cemis-iceland/co2_sensor_node/3D_models/SOP-8_4.4x5.0mm_P1.27mm.step

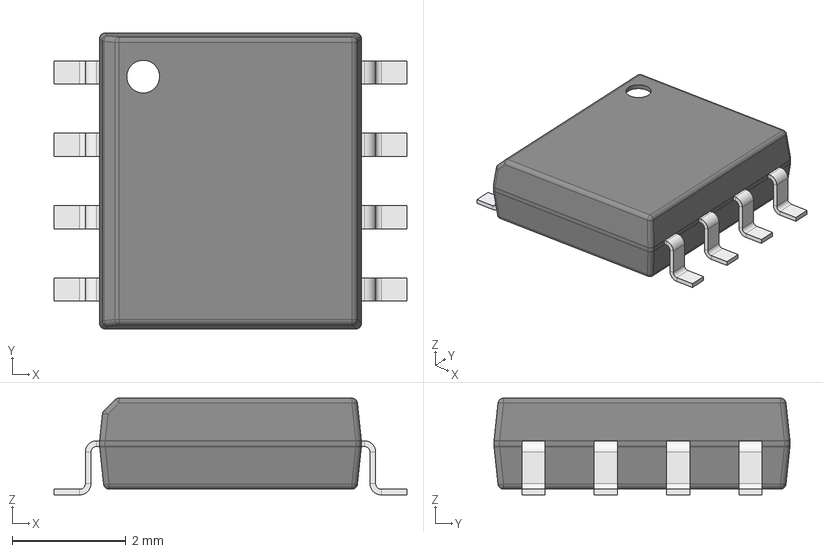
[picture p1: CAD file, 2022-05-19]
3D_models/SOP-8_4.4x5.0mm_P1.27mm.step
6.20 x 5.20 x 1.70 mm
Open_CASCADE_STEP_translator_6.8_1.1
Open_CASCADE_STEP_translator_6.8_1.2.1
Leader x 8
