cemis-iceland/co2_sensor_node/co2_sensor_node.step

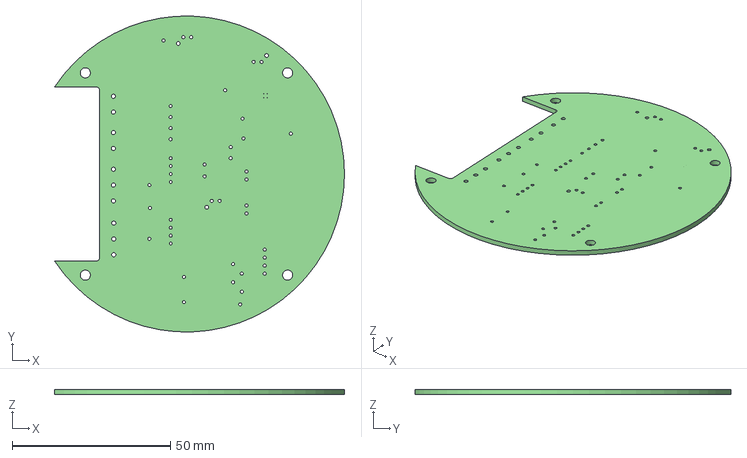
[picture p2: CAD file, 2022-07-26]
co2_sensor_node.step
91.7 x 99.9 x 1.60 mm
