cemis-iceland/co2_sensor_node/(list of files, cad)

Other CAD files:
3D_models/co2_sensor_node.step
