cemis-iceland/co2_sensor_node/(threads)

Thread 5 (2021-06-03):

I2C lines on input only pins on ESP32

manaljosid, 2021-06-03:
The I2C lines are connected to the input only pins on the ESP32. Move them to the two other free pins.

cemis-iceland, 2021-06-14:
Resolved in 2f20cff

Closed 2021-06-14.

Thread 8 (2021-06-15):

PMOS in CO2 sensor loadswitch is corrected incorrectly

cemis-iceland, 2021-06-15:
The source and drain are swapped.

manaljosid, 2021-06-21:
PMOS rotated to work correctly.

Closed 2021-06-21.

Thread 11 (2022-06-23):

Battery header reversed

manaljosid, 2022-06-23:
The battery header is reversed compared to other designs we've made, fix plz

Thread 12 (2022-06-23):

Add 220uF capacitor to the 3V3 rail and charge resistor to 220uF capacitor on the 3V3 switched rail

manaljosid, 2022-06-23:
The 220uF capacitor on the 3V3 switched rail triggers a brownout on the ESP32, fix by adding a chonk capacitor to the 3V3 rail and a charge resistor to the 3V3 switched capacitor

Thread 15 (2022-06-24):

Voltage stability for ADC

manaljosid, 2022-06-24:
The battery voltage measurements and soil moisture measurements rely on the internal ESP32 ADC. The reference for that ADC is the same 3V3 bus as is used for the rest of the board which is very noisy.

manaljosid, 2022-06-27:
Measurements show that the peak-to-peak voltage on the 3V3 rail is roughly 50 mV p-p while the RMS voltage is about 20 mV RMS.
