cemis-iceland/co2_sensor_node/PDFs/co2_sensor_node-2022-06-07.pdf

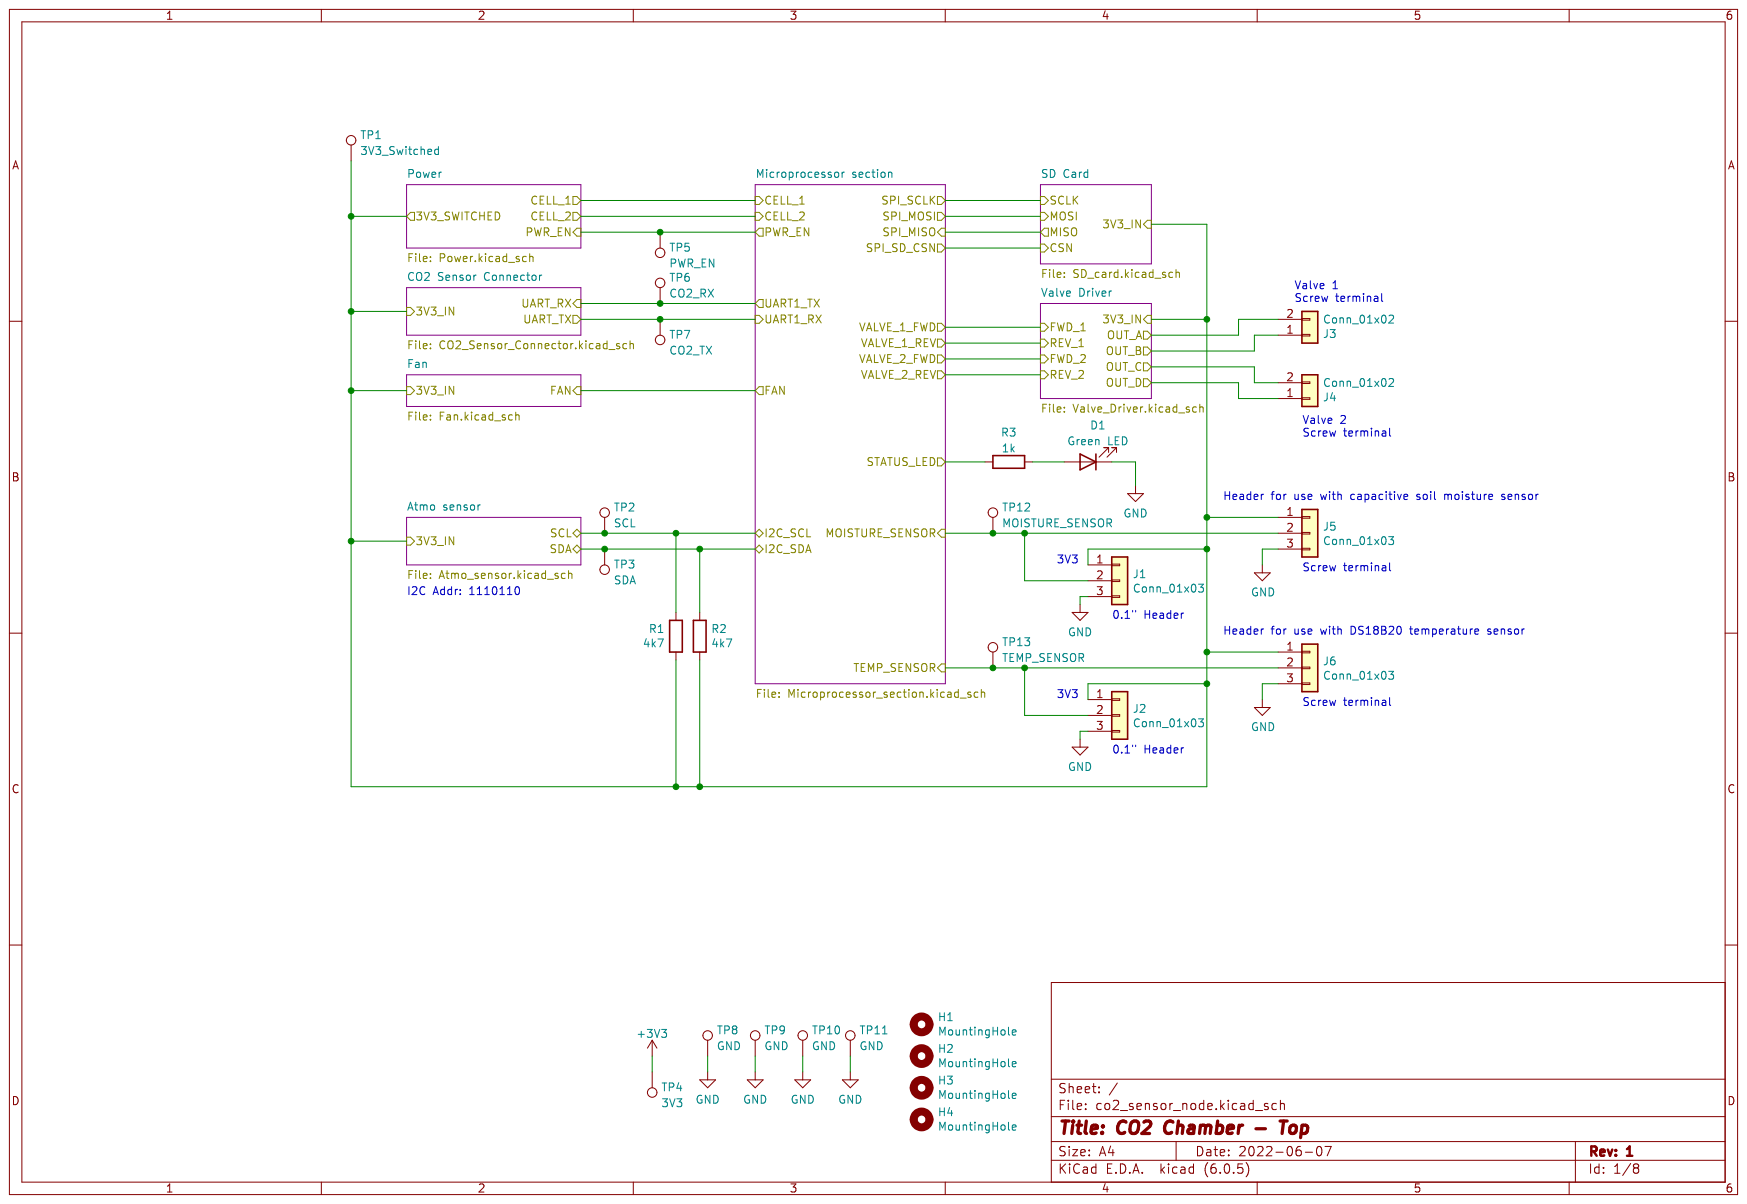
[picture p11: page 1]

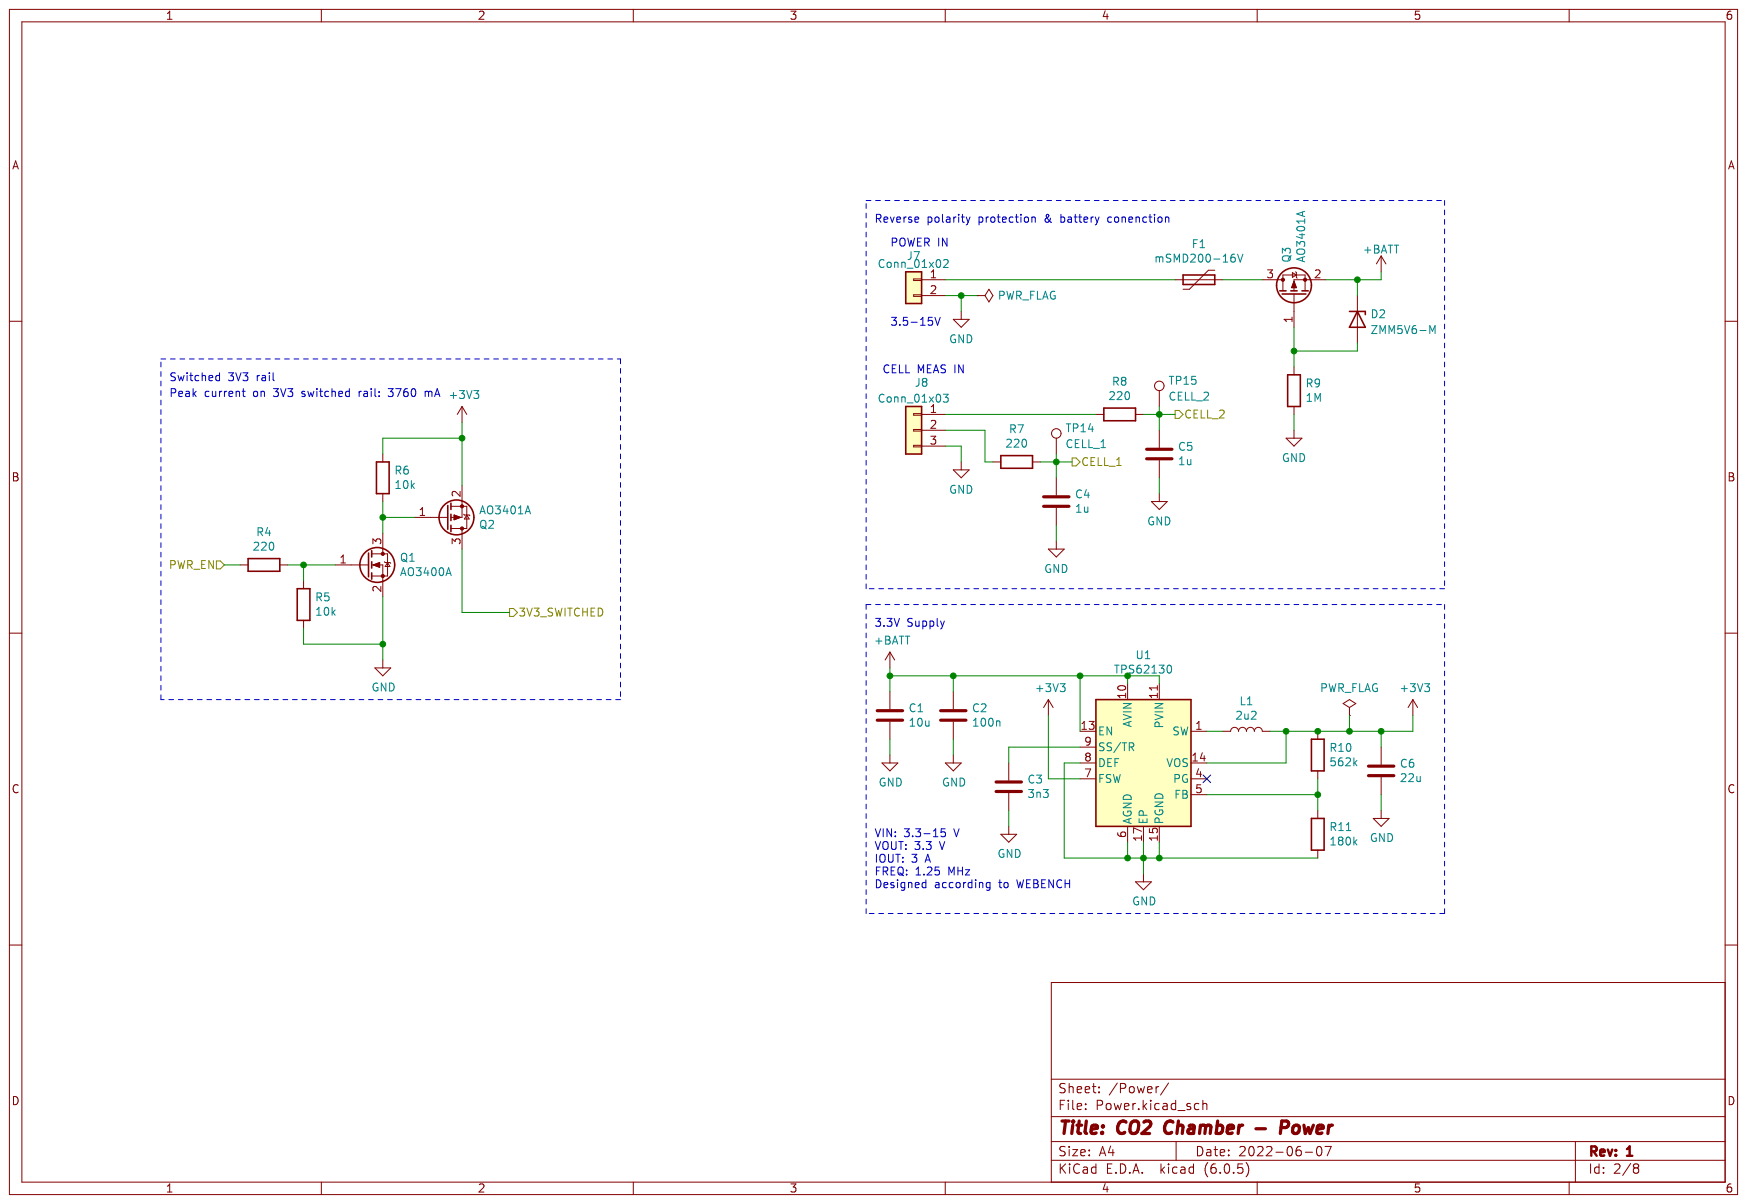
[picture p12: page 2]



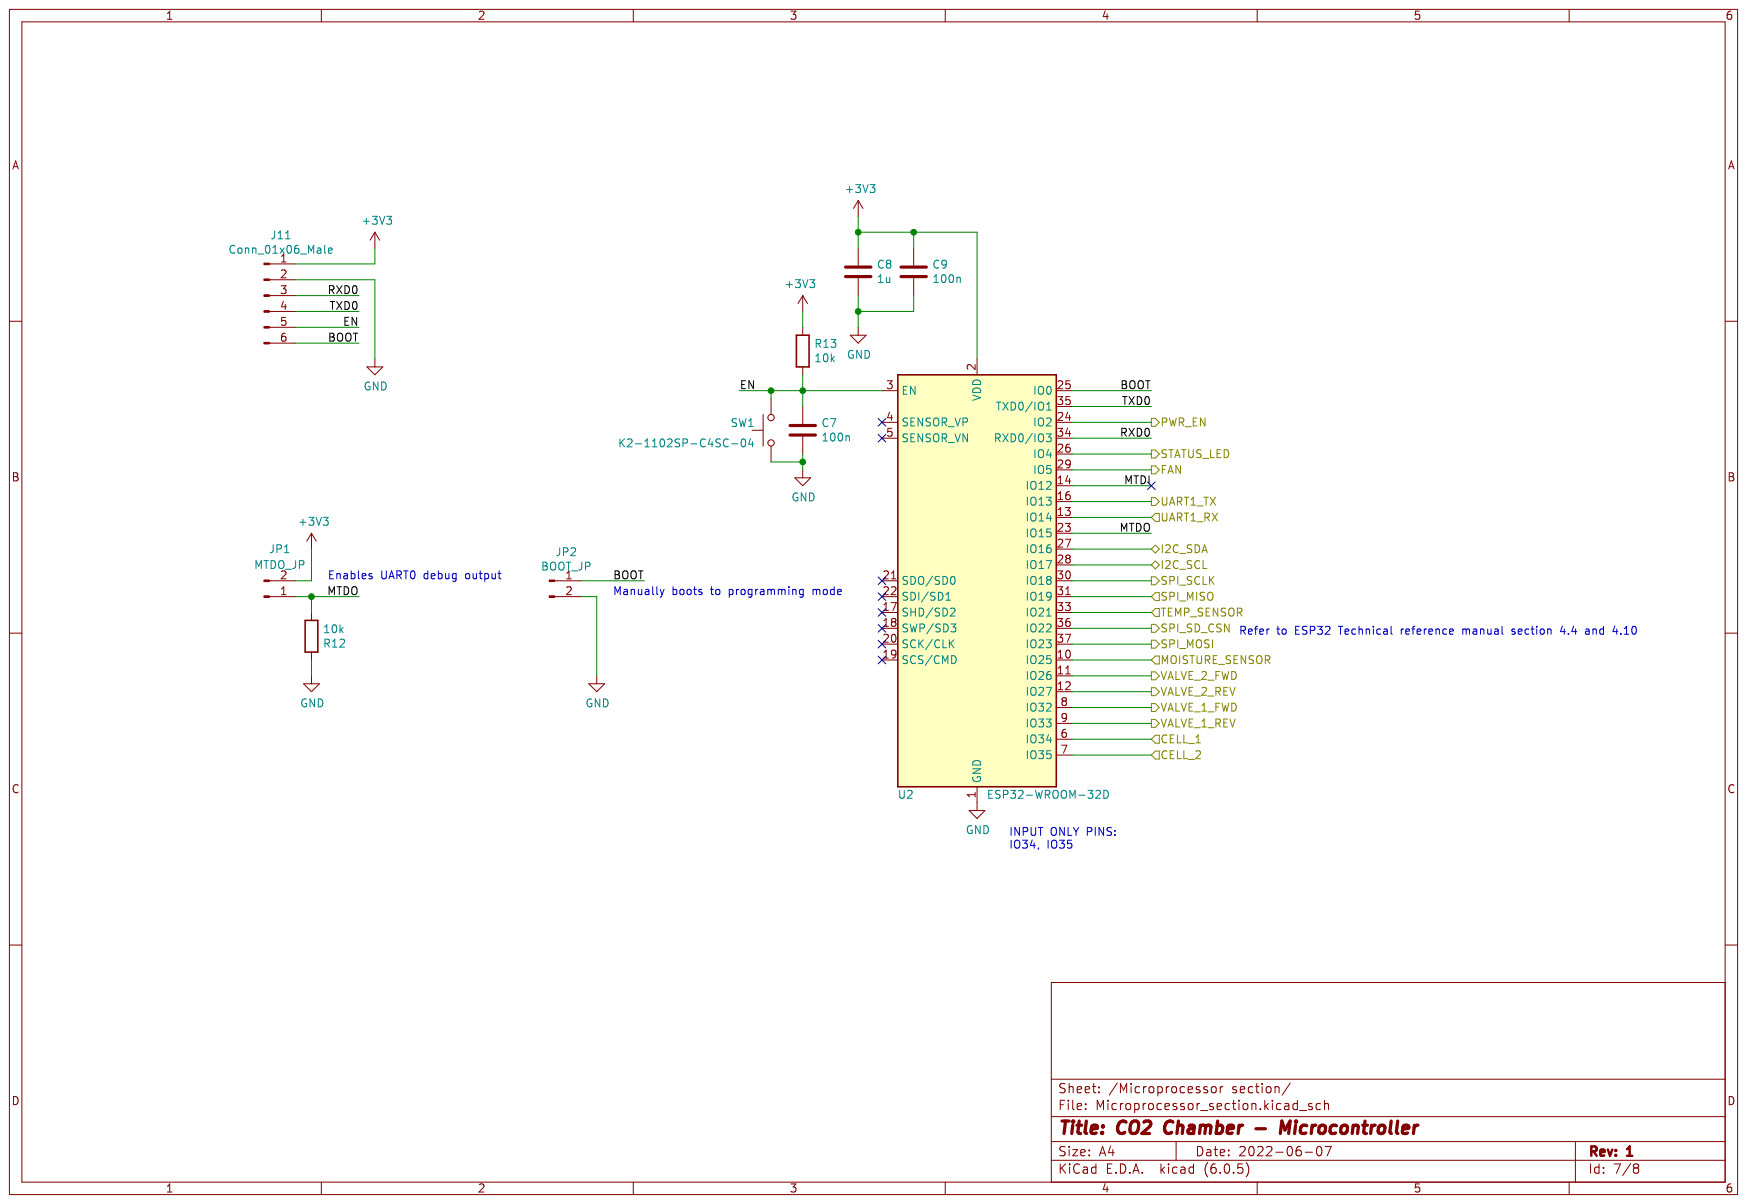
[picture p13: page 5]

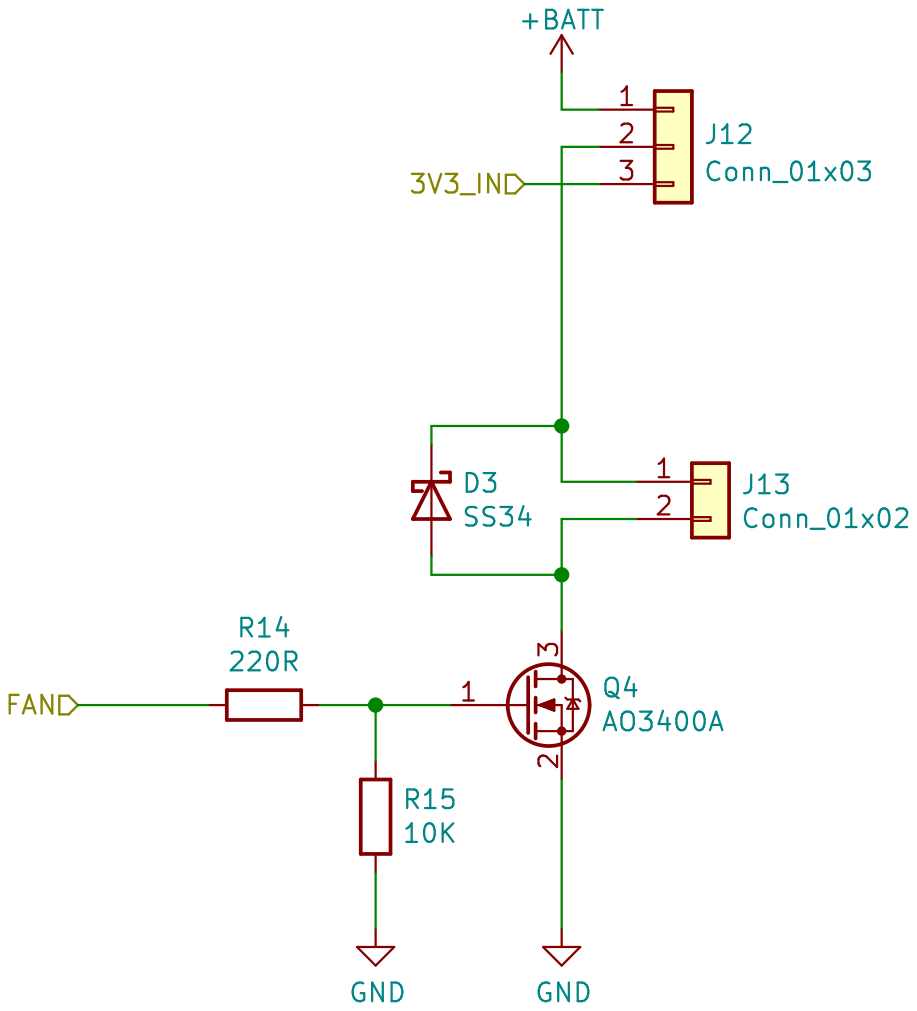
[picture p14: page 6]

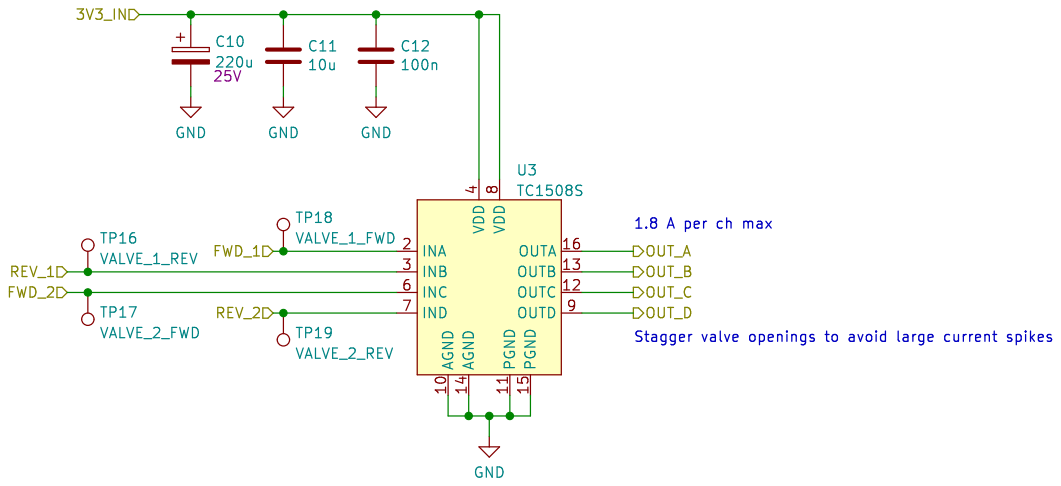
[picture p15: page 7]

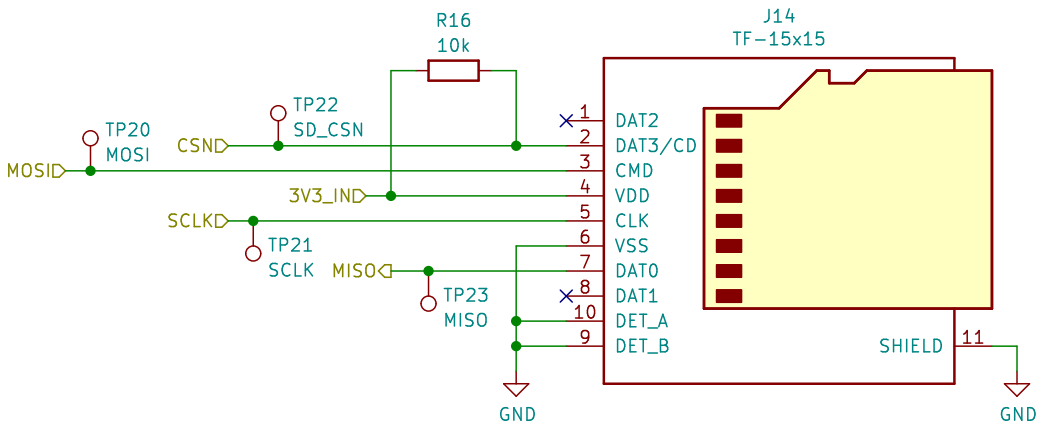
[picture p16: page 8]
