cemis-iceland/co2_sensor_node/PDFs/co2_sensor_node.pdf

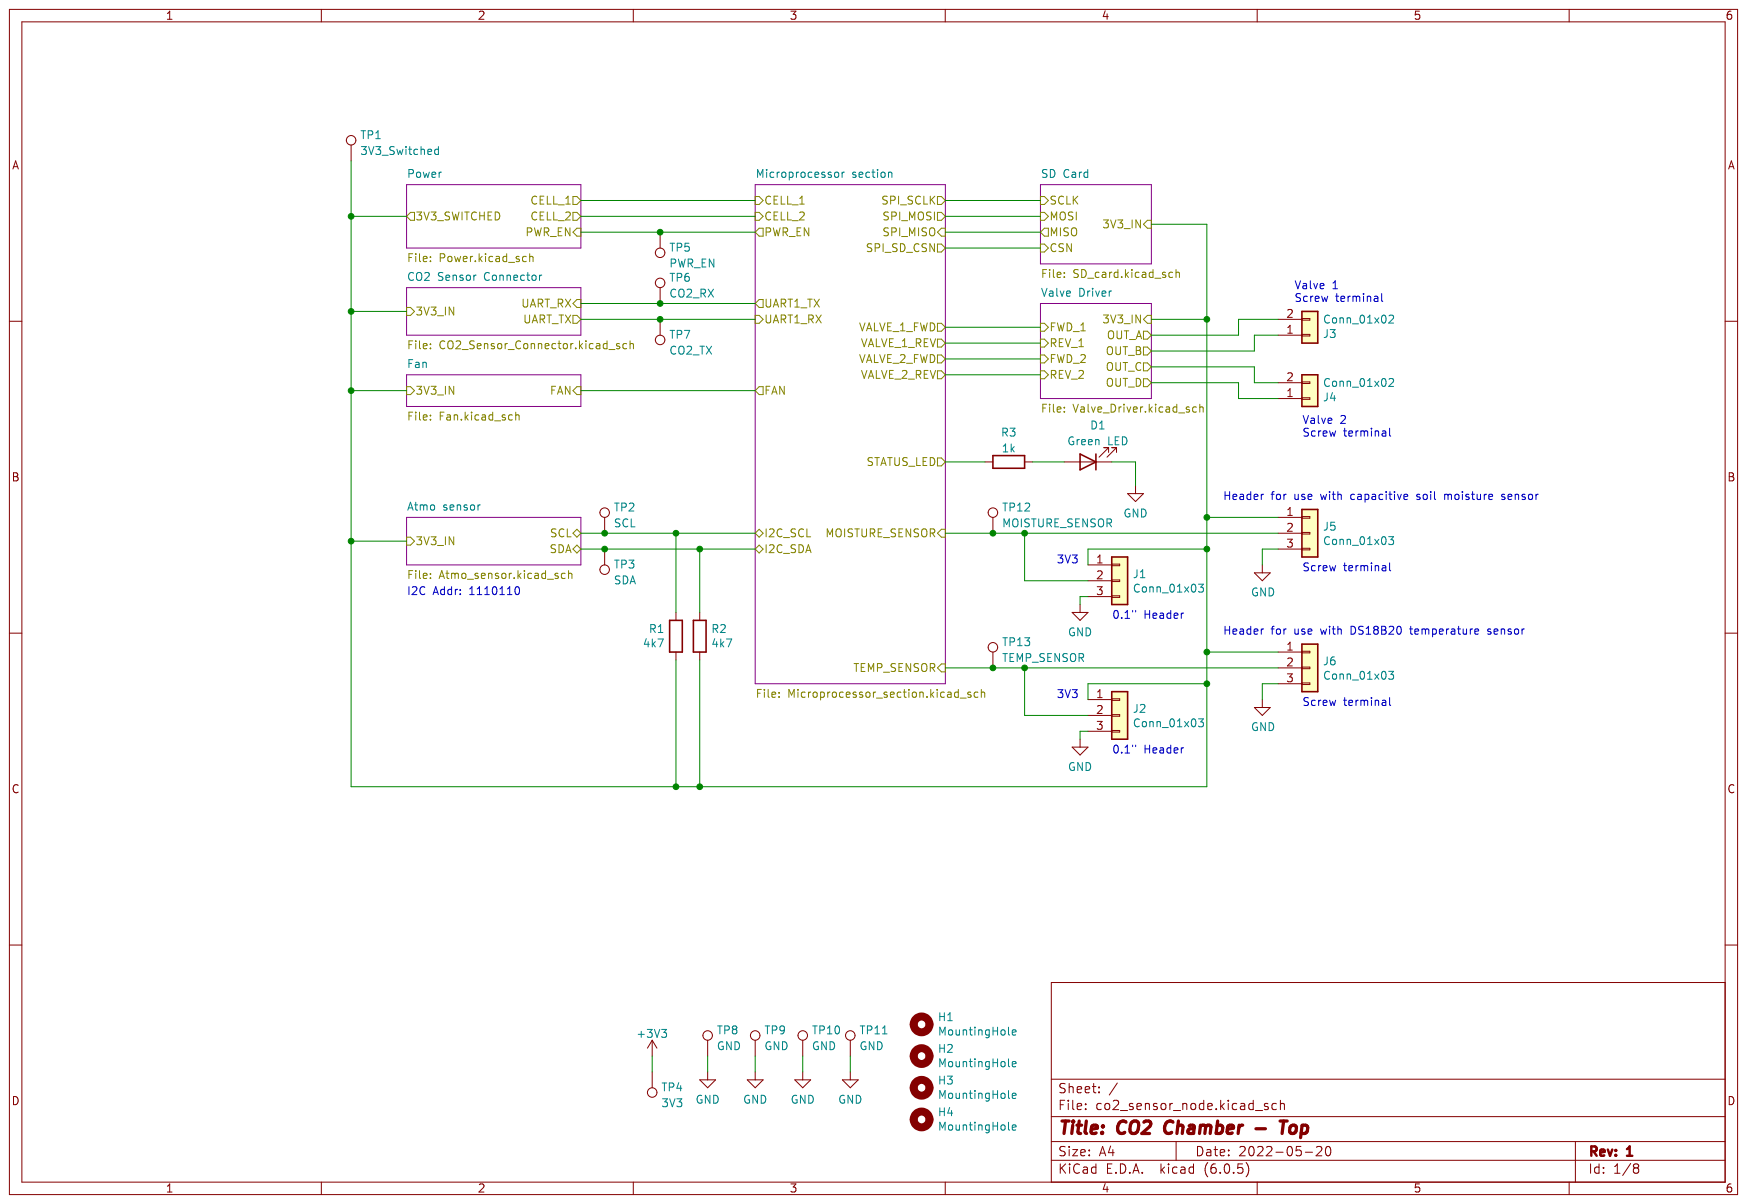
[picture p35: page 1]

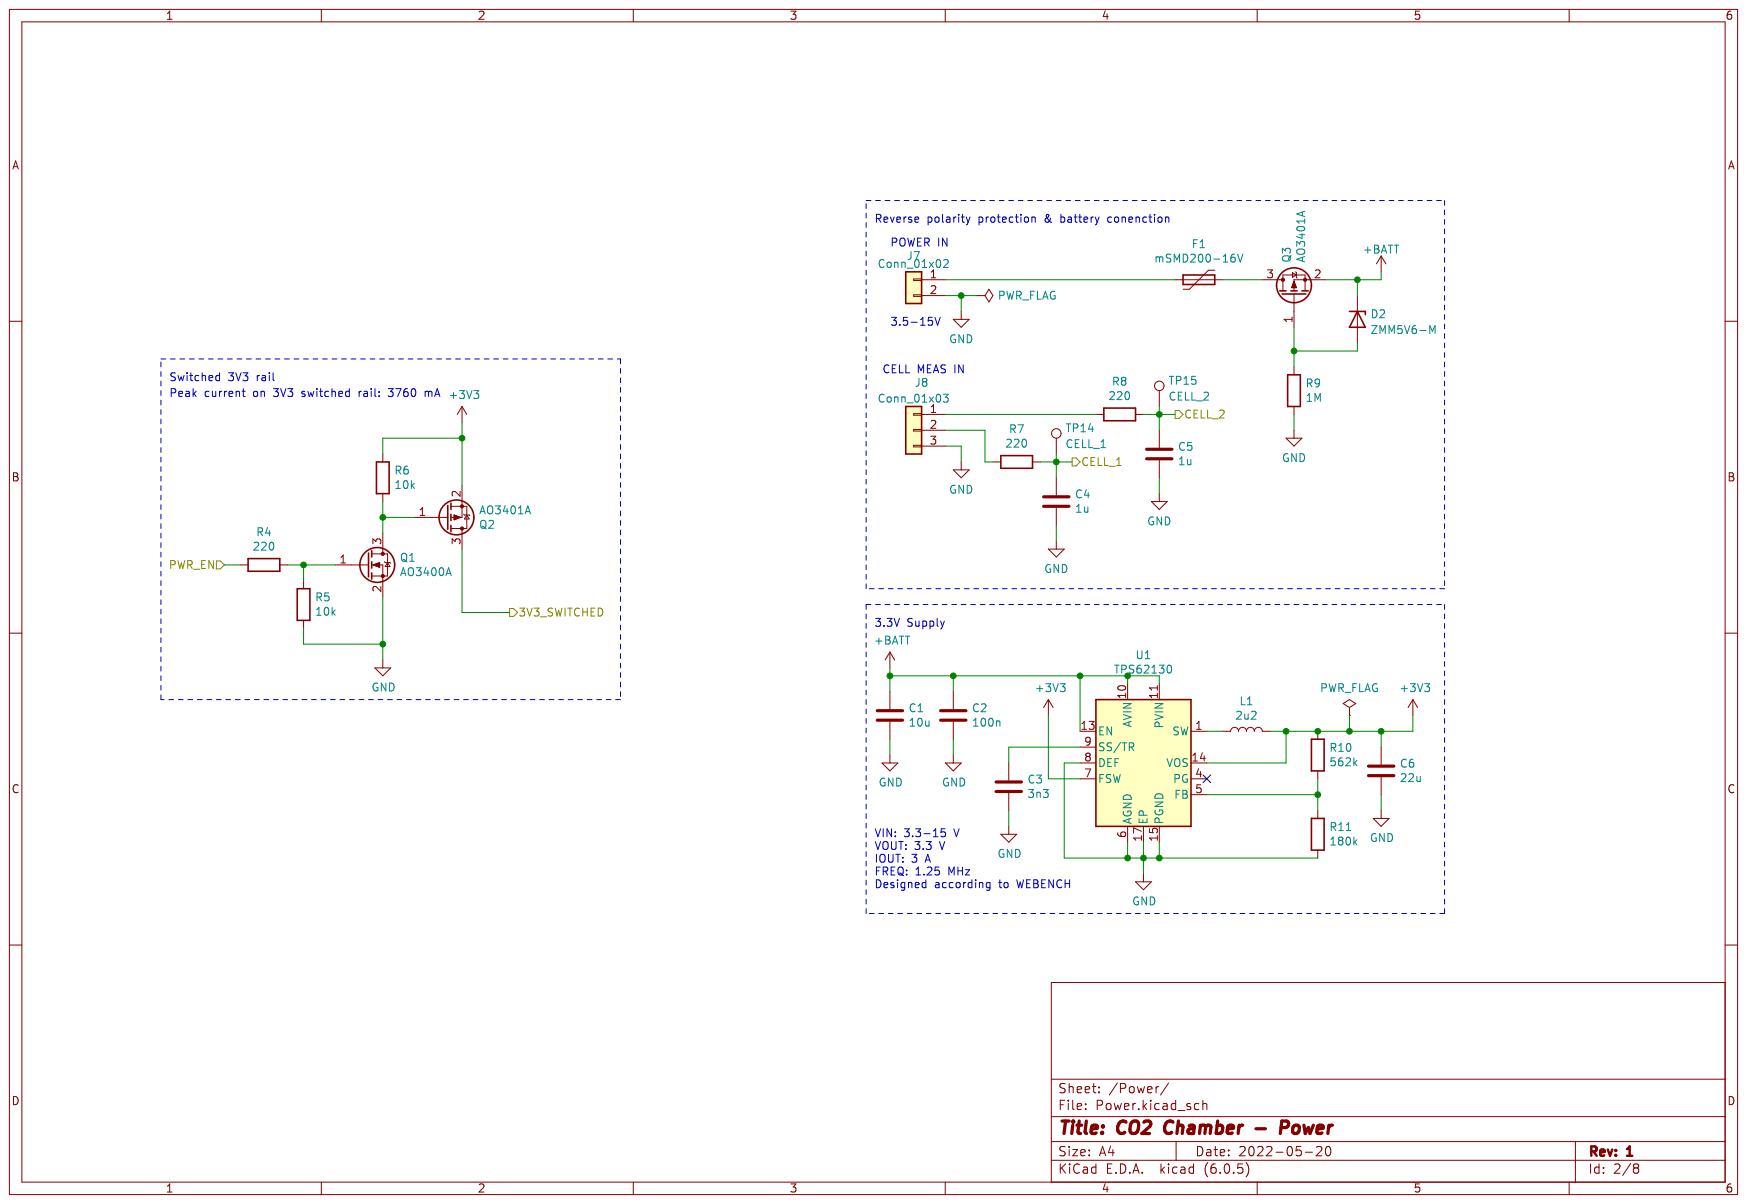
[picture p36: page 2]



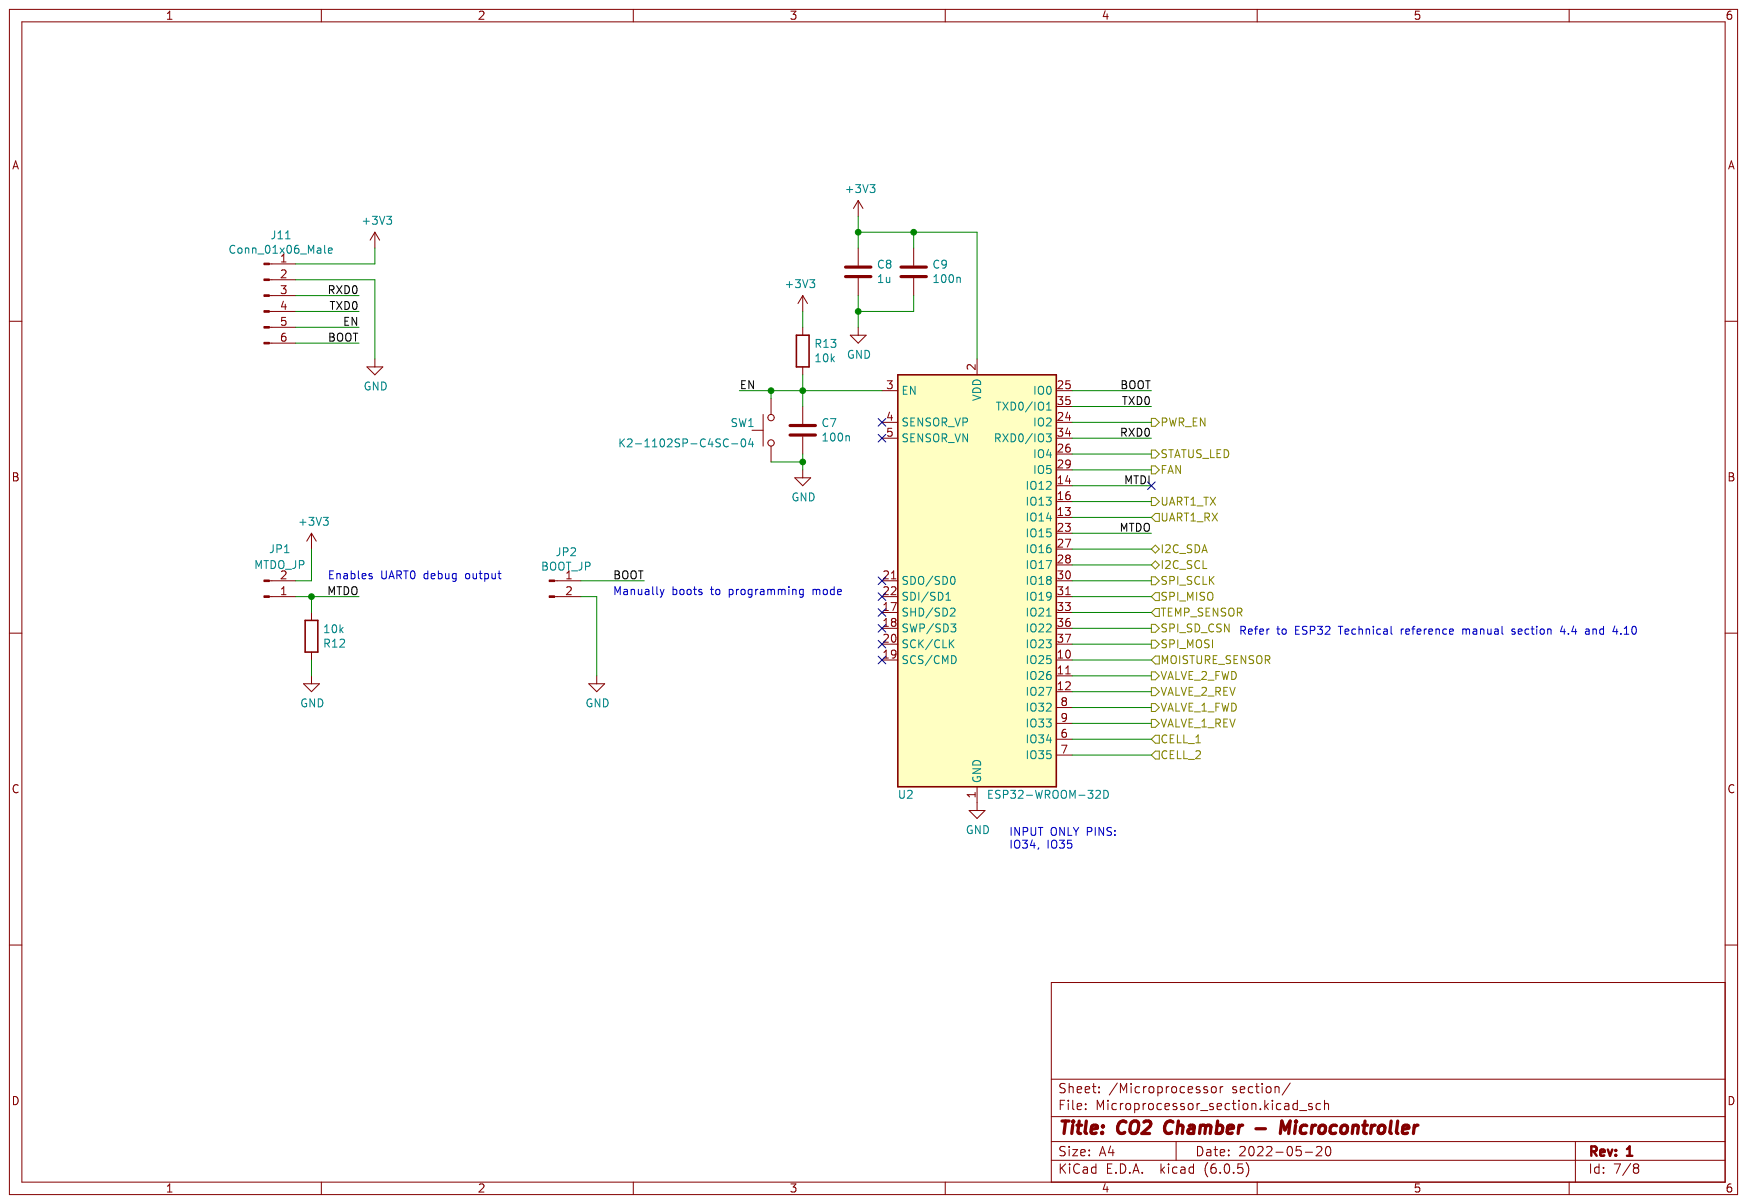
[picture p37: page 5]
