cemis-iceland/co2_sensor_node/co2_sensor_node.kicad_pcb

## KiCad design co2_sensor_node.kicad_pcb (2022-08-04)

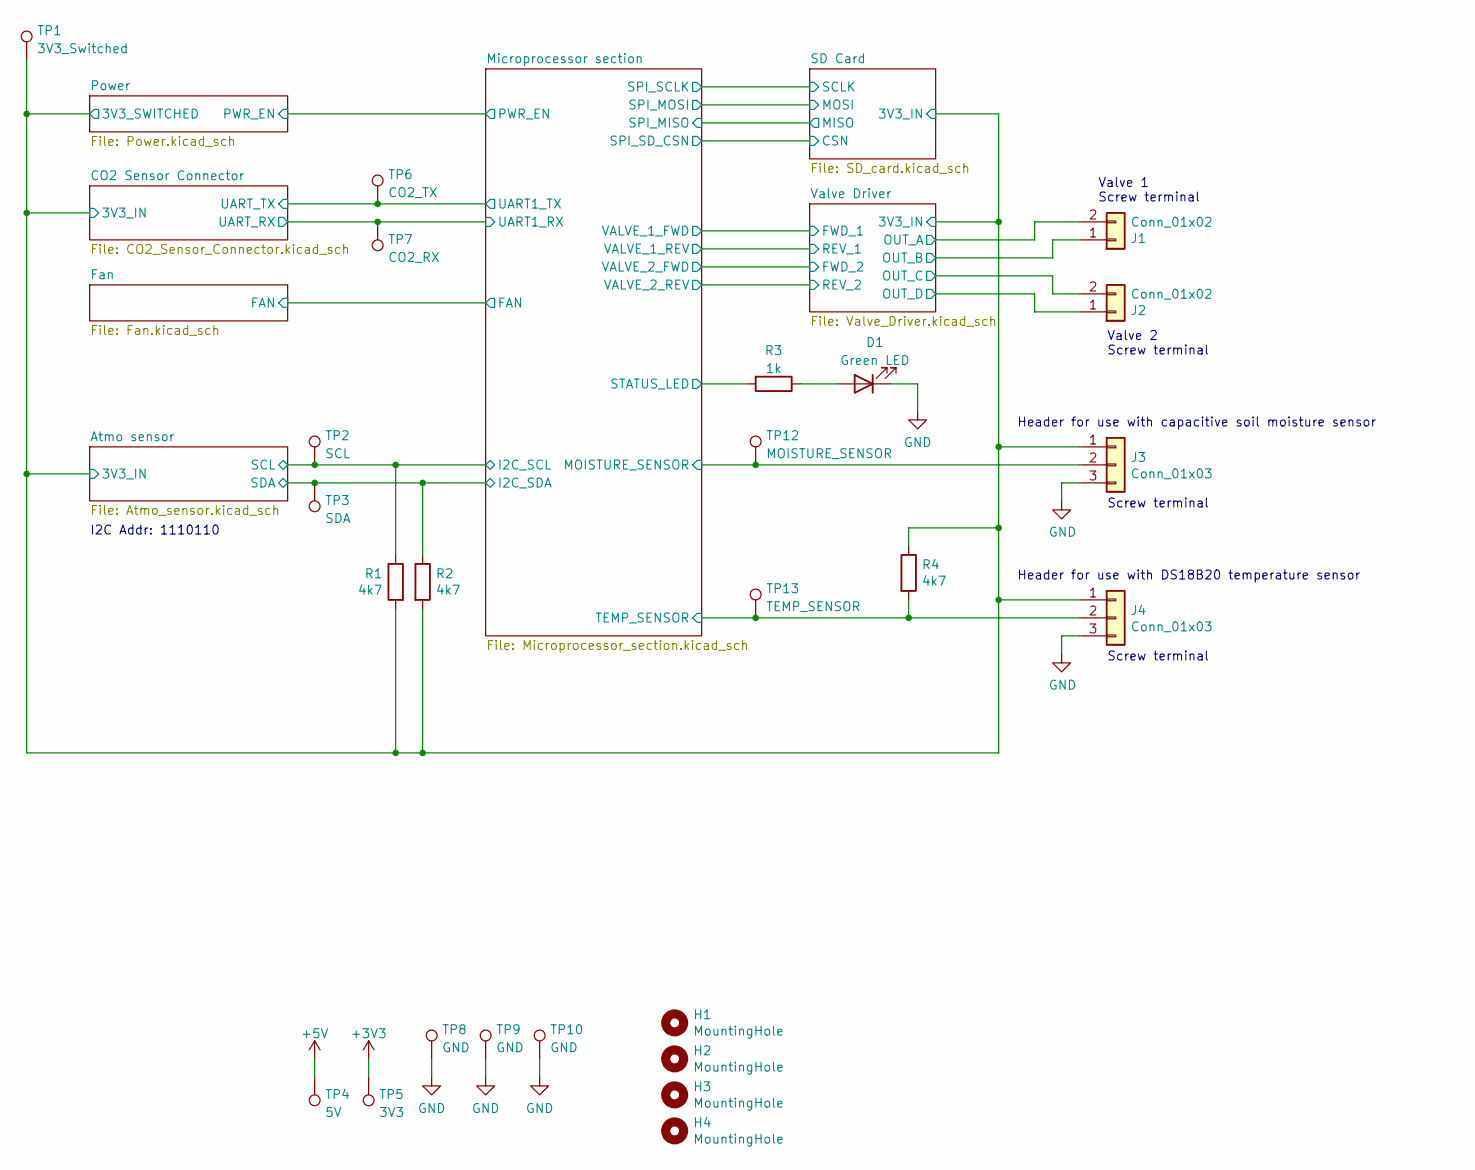
[picture p38: schematic co2_sensor_node.kicad_sch, CO2 Chamber - Top]

Parts:
D1: Green LED; LED_0603_1608Metric; LCSC C72043
H1, H2, H3, H4: MountingHole; MountingHole_3.2mm_M3
J1, J2: Conn_01x02; KF301-5.0-2P; LCSC C474881
J3, J4: Conn_01x03; KF301-5.0-3P; LCSC C474882
R1, R2, R4: 4k7; R_0603_1608Metric; LCSC C23162
R3: 1k; R_0603_1608Metric; LCSC C21190
TP1: 3V3_Switched; TestPoint_Loop_D2.50mm_Drill1.0mm_LowProfile
TP2: SCL; TestPoint_Loop_D2.50mm_Drill1.0mm_LowProfile
TP3: SDA; TestPoint_Loop_D2.50mm_Drill1.0mm_LowProfile
TP4: 5V; TestPoint_Loop_D2.50mm_Drill1.0mm_LowProfile
TP5: 3V3; TestPoint_Loop_D2.50mm_Drill1.0mm_LowProfile
TP6: CO2_TX; TestPoint_Loop_D2.50mm_Drill1.0mm_LowProfile
TP7: CO2_RX; TestPoint_Loop_D2.50mm_Drill1.0mm_LowProfile
TP8, TP9, TP10: GND; TestPoint_Loop_D2.50mm_Drill1.0mm_LowProfile
TP12: MOISTURE_SENSOR; TestPoint_Loop_D2.50mm_Drill1.0mm_LowProfile
TP13: TEMP_SENSOR; TestPoint_Loop_D2.50mm_Drill1.0mm_LowProfile

Connections:
+3V3: TP5.1; also elsewhere on the board
+5V: TP4.1; also elsewhere on the board
/Atmo sensor/3V3_IN: J3.1, J4.1, R1.2, R2.2, R4.1, TP1.1; also elsewhere on the board
/Atmo sensor/SCL: R1.1, TP2.1; also elsewhere on the board
/Atmo sensor/SDA: R2.1, TP3.1; also elsewhere on the board
/CO2 Sensor Connector/UART_RX: TP7.1; also elsewhere on the board
/CO2 Sensor Connector/UART_TX: TP6.1; also elsewhere on the board
/Microprocessor section/MOISTURE_SENSOR: J3.2, TP12.1; also elsewhere on the board
/Microprocessor section/STATUS_LED: R3.2; also elsewhere on the board
/Microprocessor section/TEMP_SENSOR: J4.2, R4.2, TP13.1; also elsewhere on the board
/Valve Driver/OUT_A: J1.2; also elsewhere on the board
/Valve Driver/OUT_B: J1.1; also elsewhere on the board
/Valve Driver/OUT_C: J2.2; also elsewhere on the board
/Valve Driver/OUT_D: J2.1; also elsewhere on the board
GND: D1.1 (K), J3.3, J4.3, TP8.1, TP9.1, TP10.1; also elsewhere on the board
unnamed: D1.2 (A), R3.1

Notes on the sheet:
I2C Addr: 1110110
Header for use with capacitive soil moisture sensor
Header for use with DS18B20 temperature sensor
Screw terminal
Valve 1 Screw terminal
Valve 2 Screw terminal

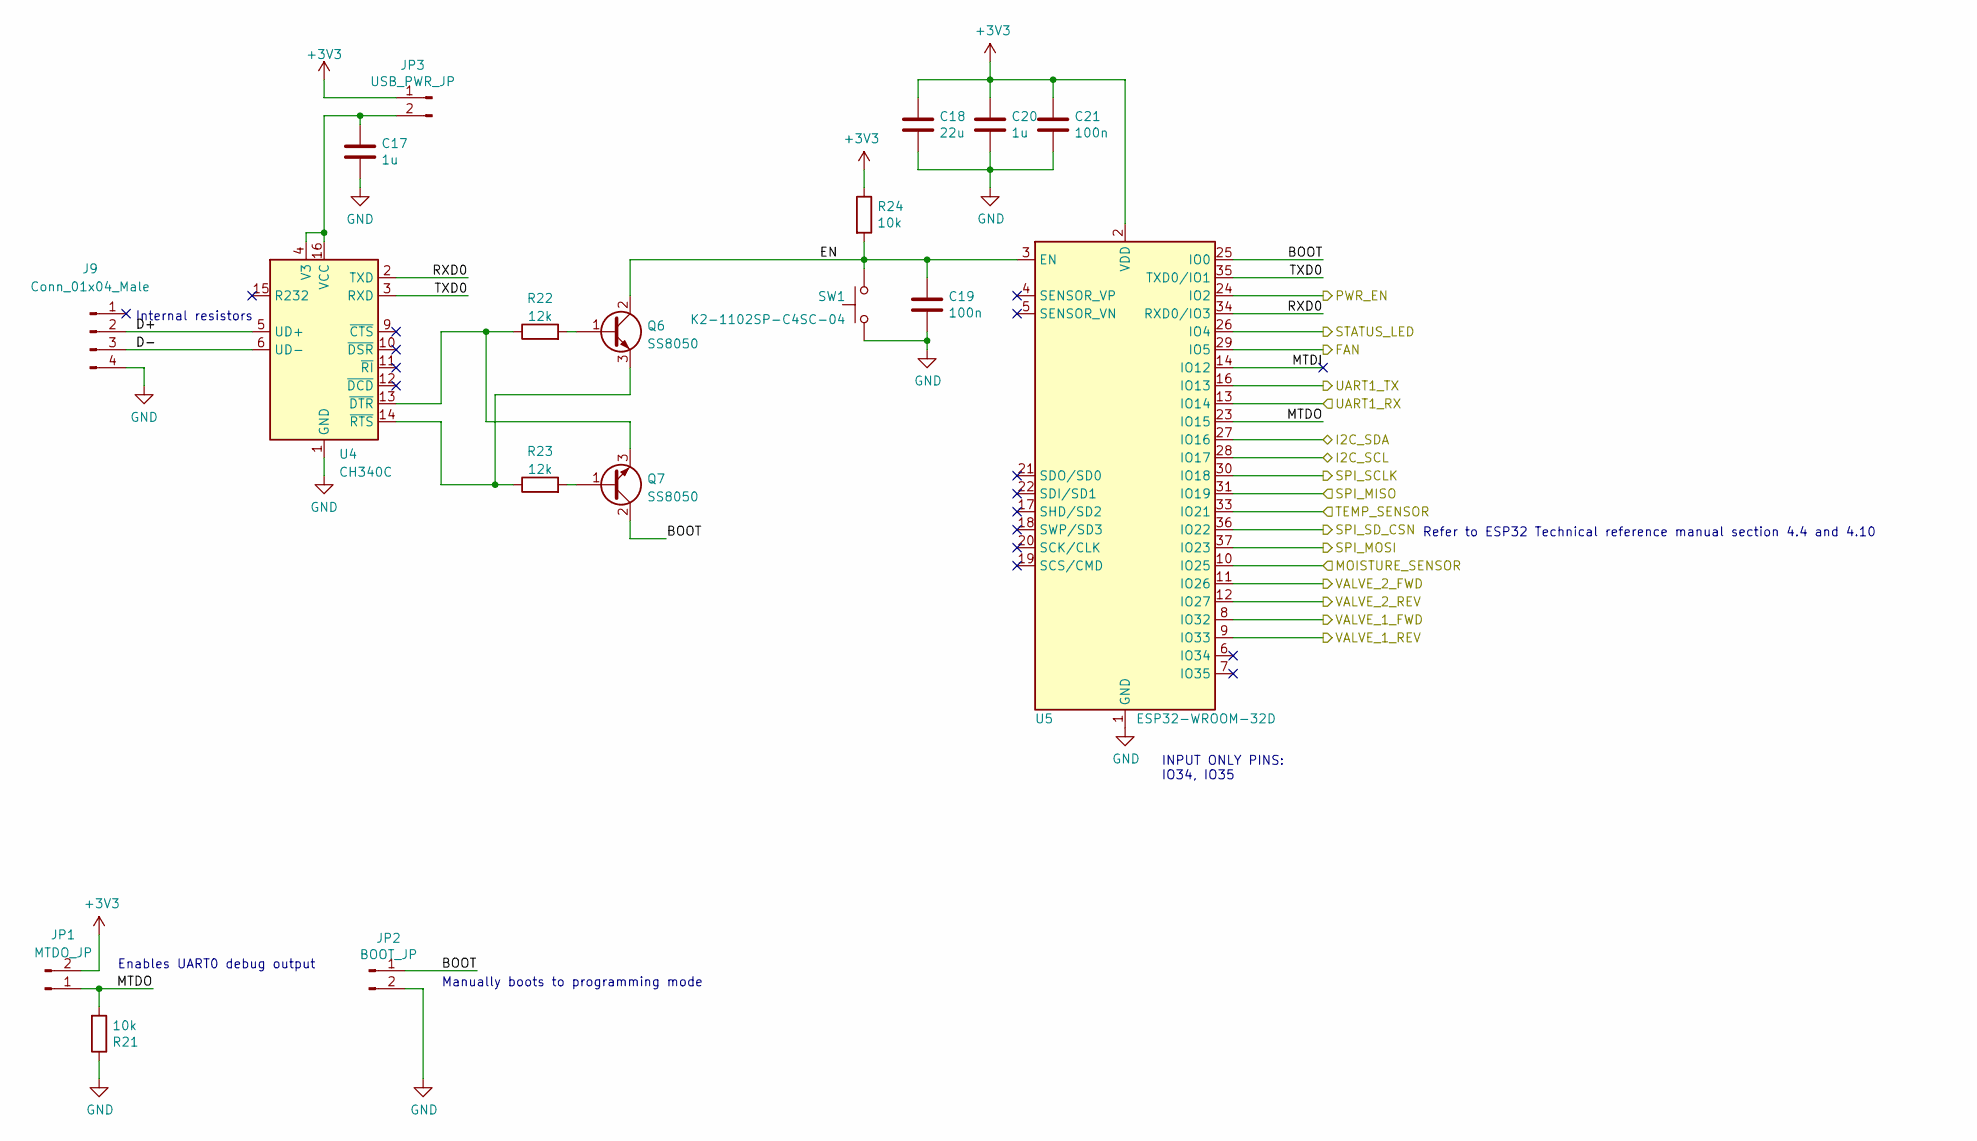
[picture p39: schematic Microprocessor_section.kicad_sch, CO2 Chamber - Microcontroller]

Parts:
C17, C20: 1u; C_0603_1608Metric; LCSC C15849
C18: 22u; C_0805_2012Metric; LCSC C45783
C19, C21: 100n; C_0603_1608Metric; LCSC C14663
J9: Conn_01x04_Male; PinHeader_1x04_P2.54mm_Vertical; LCSC C492403
JP1: MTDO_JP; PinHeader_1x02_P2.54mm_Vertical; LCSC C160332
JP2: BOOT_JP; PinHeader_1x02_P2.54mm_Vertical; LCSC C160332
JP3: USB_PWR_JP; PinHeader_1x02_P2.54mm_Vertical; LCSC C160332
Q6, Q7: SS8050; SOT-23; LCSC C2150
R21, R24: 10k; R_0603_1608Metric; LCSC C25804
R22, R23: 12k; R_0603_1608Metric; LCSC C22790
SW1: K2-1102SP-C4SC-04; K2-1102SP-xxxC; LCSC C127509
U4: CH340C; SOIC-16_3.9x9.9mm_P1.27mm; LCSC C84681
U5: ESP32-WROOM-32D; ESP32-WROOM-32; LCSC C473012

Connections:
+3V3: C18.1, C20.1, C21.1, JP1.2, JP3.1, R24.1, U5.2 (VDD); also elsewhere on the board
/Atmo sensor/SCL: U5.28 (IO17); also elsewhere on the board
/Atmo sensor/SDA: U5.27 (IO16); also elsewhere on the board
/CO2 Sensor Connector/UART_RX: U5.13 (IO14); also elsewhere on the board
/CO2 Sensor Connector/UART_TX: U5.16 (IO13); also elsewhere on the board
/Fan/FAN: U5.29 (IO5); also elsewhere on the board
/Microprocessor section/BOOT: JP2.1, Q7.2 (C), U5.25 (IO0)
/Microprocessor section/D+: J9.2, U4.5 (UD+)
/Microprocessor section/D-: J9.3, U4.6 (UD-)
/Microprocessor section/EN: C19.1, Q6.2 (C), R24.2, SW1.2, U5.3 (EN)
/Microprocessor section/MOISTURE_SENSOR: U5.10 (IO25); also elsewhere on the board
/Microprocessor section/MTDI: U5.14 (IO12)
/Microprocessor section/MTDO: JP1.1, R21.2, U5.23 (IO15)
/Microprocessor section/PWR_EN: U5.24 (IO2); also elsewhere on the board
/Microprocessor section/RXD0: U4.2 (TXD), U5.34 (RXD0/IO3)
/Microprocessor section/SPI_MISO: U5.31 (IO19); also elsewhere on the board
/Microprocessor section/SPI_MOSI: U5.37 (IO23); also elsewhere on the board
/Microprocessor section/SPI_SCLK: U5.30 (IO18); also elsewhere on the board
/Microprocessor section/SPI_SD_CSN: U5.36 (IO22); also elsewhere on the board
/Microprocessor section/STATUS_LED: U5.26 (IO4); also elsewhere on the board
/Microprocessor section/TEMP_SENSOR: U5.33 (IO21); also elsewhere on the board
/Microprocessor section/TXD0: U4.3 (RXD), U5.35 (TXD0/IO1)
/Microprocessor section/VALVE_1_FWD: U5.8 (IO32); also elsewhere on the board
/Microprocessor section/VALVE_1_REV: U5.9 (IO33); also elsewhere on the board
/Microprocessor section/VALVE_2_FWD: U5.11 (IO26); also elsewhere on the board
/Microprocessor section/VALVE_2_REV: U5.12 (IO27); also elsewhere on the board
GND: C17.2, C18.2, C19.2, C20.2, C21.2, J9.4, JP2.2, R21.1, SW1.1, U4.1 (GND), U5.1 (GND), U5.15 (GND), U5.38 (GND), U5.39 (GND); also elsewhere on the board
unnamed: C17.1, JP3.2, U4.4 (V3), U4.16 (VCC)
unnamed: Q6.1 (B), R22.2
unnamed: Q6.3 (E), R23.1, U4.14 (~RTS)
unnamed: Q7.1 (B), R23.2
unnamed: Q7.3 (E), R22.1, U4.13 (~DTR)

Notes on the sheet:
INPUT ONLY PINS: IO34, IO35
Refer to ESP32 Technical reference manual section 4.4 and 4.10
Internal resistors
Manually boots to programming mode
Enables UART0 debug output

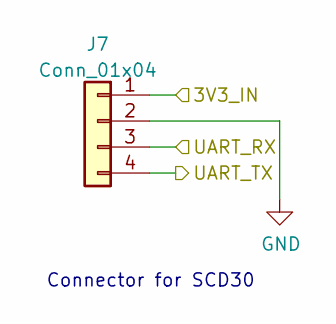
[picture p40: schematic CO2_Sensor_Connector.kicad_sch, CO2 Chamber - CO2 Sensor Connector]

Parts:
J7: Conn_01x04; JST_XH_B4B-XH-A_1x04_P2.50mm_Vertical; LCSC C37815

Connections:
/Atmo sensor/3V3_IN: J7.1; also elsewhere on the board
/CO2 Sensor Connector/UART_RX: J7.3; also elsewhere on the board
/CO2 Sensor Connector/UART_TX: J7.4; also elsewhere on the board
GND: J7.2; also elsewhere on the board

Notes on the sheet:
Connector for SCD30

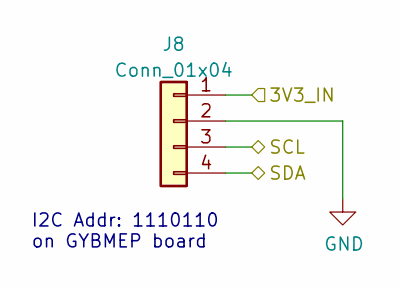
[picture p41: schematic Atmo_sensor.kicad_sch, CO2 Chamber - Atmospheric Sensor Connector]

Parts:
J8: Conn_01x04; JST_XH_B4B-XH-A_1x04_P2.50mm_Vertical; LCSC C37815

Connections:
/Atmo sensor/3V3_IN: J8.1; also elsewhere on the board
/Atmo sensor/SCL: J8.3; also elsewhere on the board
/Atmo sensor/SDA: J8.4; also elsewhere on the board
GND: J8.2; also elsewhere on the board

Notes on the sheet:
I2C Addr: 1110110 on GYBMEP board

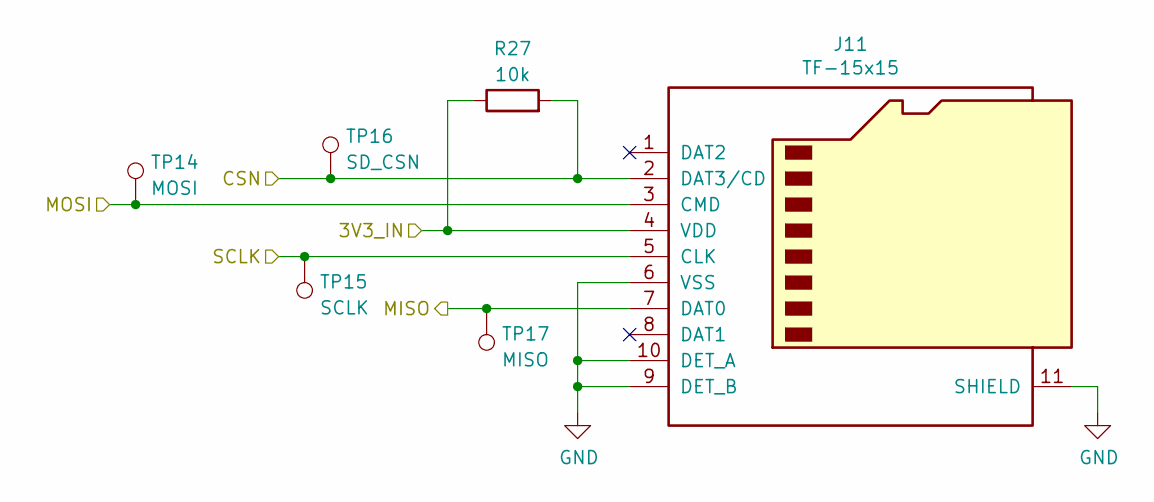
[picture p42: schematic SD_card.kicad_sch, CO2 Chamber - SD Card]

Parts:
J11: TF-15x15; LCSC C111196
R27: 10k; R_0603_1608Metric; LCSC C25804
TP14: MOSI; TestPoint_Loop_D2.50mm_Drill1.0mm_LowProfile
TP15: SCLK; TestPoint_Loop_D2.50mm_Drill1.0mm_LowProfile
TP16: SD_CSN; TestPoint_Loop_D2.50mm_Drill1.0mm_LowProfile
TP17: MISO; TestPoint_Loop_D2.50mm_Drill1.0mm_LowProfile

Connections:
/Atmo sensor/3V3_IN: J11.4 (VDD), R27.1; also elsewhere on the board
/Microprocessor section/SPI_MISO: J11.7 (DAT0), TP17.1; also elsewhere on the board
/Microprocessor section/SPI_MOSI: J11.3 (CMD), TP14.1; also elsewhere on the board
/Microprocessor section/SPI_SCLK: J11.5 (CLK), TP15.1; also elsewhere on the board
/Microprocessor section/SPI_SD_CSN: J11.2 (DAT3/CD), R27.2, TP16.1; also elsewhere on the board
GND: J11.6 (VSS), J11.9 (DET_B), J11.10 (DET_A), J11.11 (SHIELD); also elsewhere on the board

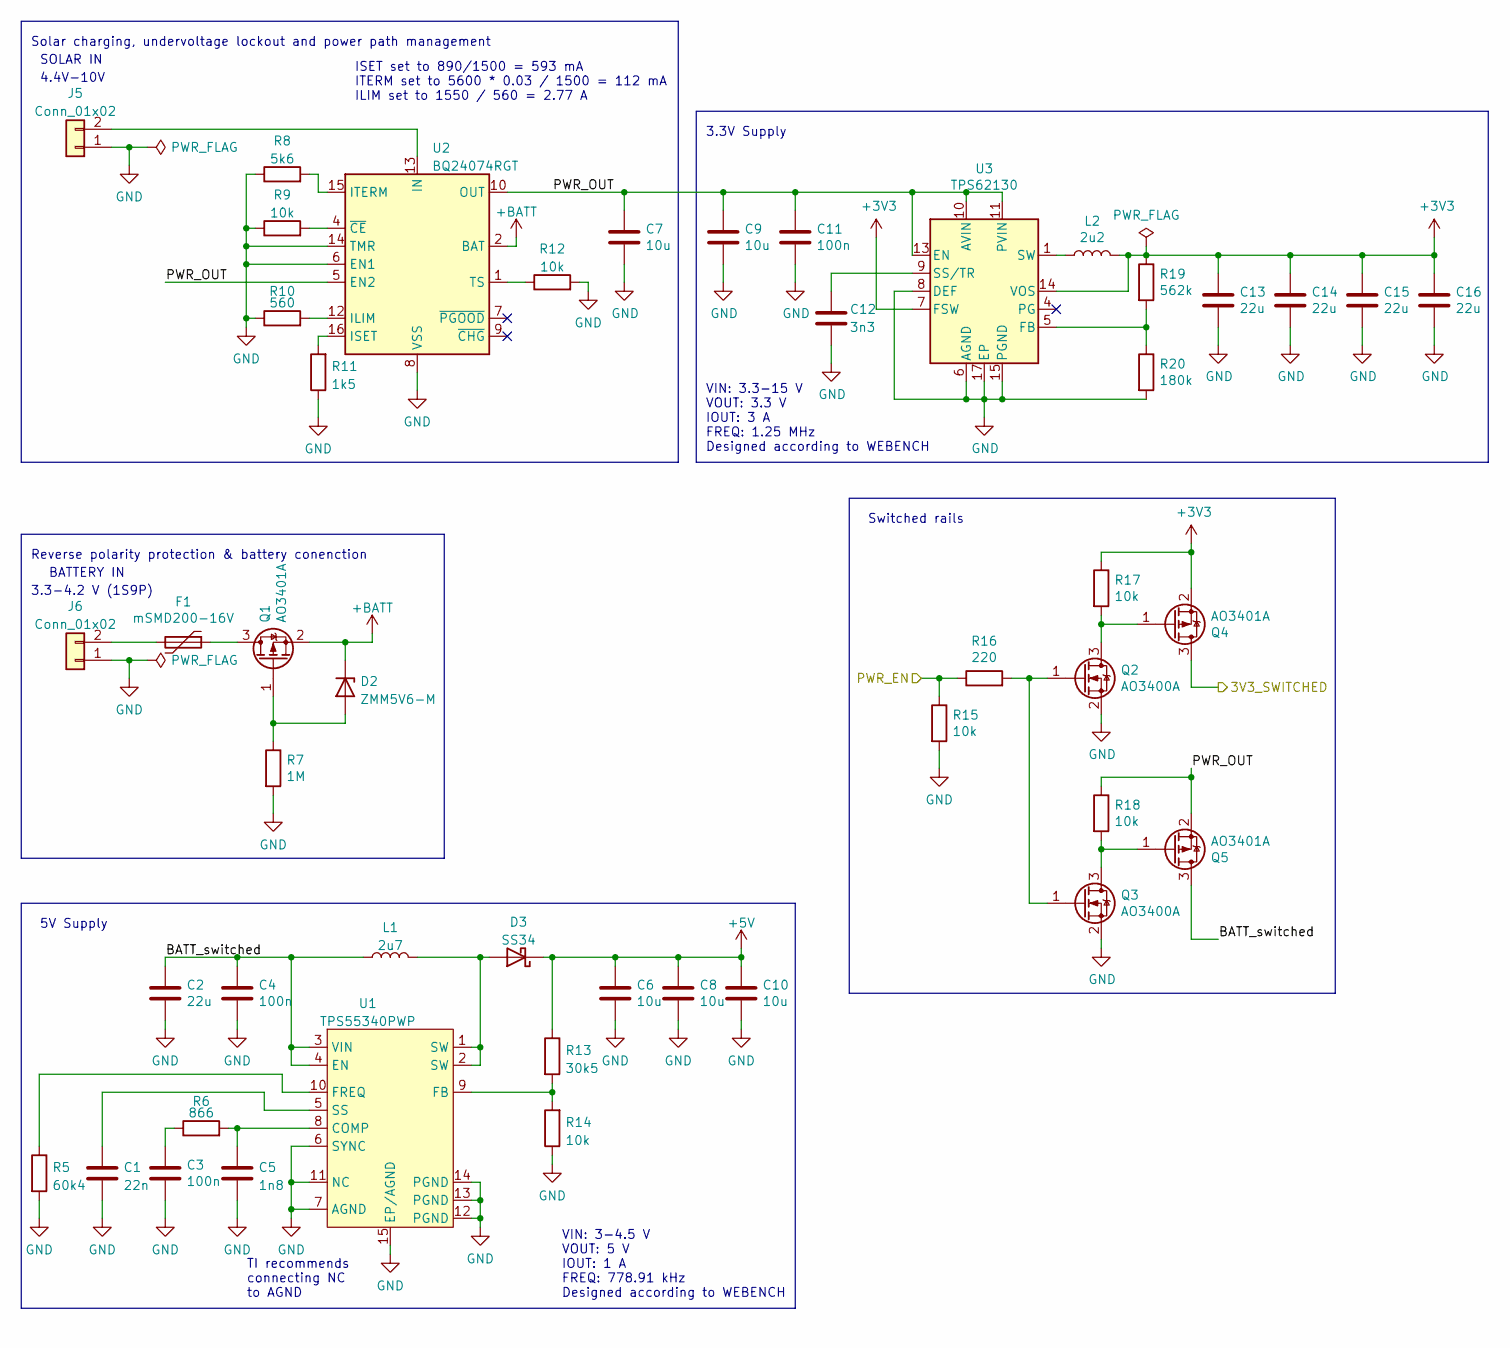
[picture p43: schematic Power.kicad_sch, CO2 Chamber - Power]

Parts:
C1: 22n; C_0603_1608Metric; LCSC C21122
C2, C13, C14, C15, C16: 22u; C_0805_2012Metric; LCSC C45783
C3, C4, C11: 100n; C_0603_1608Metric; LCSC C14663
C5: 1n8; C_0603_1608Metric; LCSC C318642
C6, C7, C8, C9, C10: 10u; C_0805_2012Metric; LCSC C15850
C12: 3n3; C_0603_1608Metric; LCSC C1613
D2: ZMM5V6-M; D_MiniMELF; LCSC C8062
D3: SS34; D_SMA; LCSC C8678
F1: mSMD200-16V; Fuse_1812_4532Metric; LCSC C70126
J5, J6: Conn_01x02; JST_XH_B2B-XH-AM_1x02_P2.50mm_Vertical; LCSC C20079
L1: 2u7; PCD0504MT2R7; LCSC C324320
L2: 2u2; WPN4020; LCSC C98361
Q1, Q4, Q5: AO3401A; SOT-23; LCSC C15127
Q2, Q3: AO3400A; SOT-23; LCSC C20917
R5: 60k4; R_0402_1005Metric; LCSC C310240
R6: 866; R_0402_1005Metric; LCSC C227251
R7: 1M; R_0603_1608Metric; LCSC C22935
R8: 5k6; R_0603_1608Metric
R9, R12, R14, R15, R17, R18: 10k; R_0603_1608Metric; LCSC C25804
R10: 560; R_0603_1608Metric
R11: 1k5; R_0603_1608Metric
R13: 30k5; R_0402_1005Metric; LCSC C185428
R16: 220; R_0603_1608Metric; LCSC C22962
R19: 562k; R_0603_1608Metric; LCSC C23205
R20: 180k; R_0603_1608Metric; LCSC C22827
U1: TPS55340PWP; HTSSOP-14-1EP_4.4x5mm_P0.65mm_EP3.4x5mm_Mask3x3.1mm_Thermal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; LCSC C43862
U2: BQ24074RGT; VQFN-16-1EP_3x3mm_P0.5mm_EP1.6x1.6mm; LCSC C54313
U3: TPS62130; VQFN-16-1EP_3x3mm_P0.5mm_EP1.68x1.68mm_ThermalVias; LCSC C43590

Connections:
+3V3: C13.1, C14.1, C15.1, C16.1, L2.2, Q4.2 (S), R17.1, R19.1, U3.7 (FSW), U3.14 (VOS); also elsewhere on the board
+5V: C6.1, C8.1, C10.1, D3.1 (K), R13.1; also elsewhere on the board
+BATT: D2.1 (K), Q1.2 (S), U2.2 (BAT), U2.3 (BAT)
/Atmo sensor/3V3_IN: Q4.3 (D); also elsewhere on the board
/Microprocessor section/PWR_EN: R15.1, R16.1; also elsewhere on the board
/Power/BATT_switched: C2.1, C4.1, L1.1, Q5.3 (D), U1.3 (VIN), U1.4 (EN)
/Power/PWR_OUT: C7.1, C9.1, C11.1, Q5.2 (S), R18.1, U2.5 (EN2), U2.10 (OUT), U2.11 (OUT), U3.10 (AVIN), U3.11 (PVIN), U3.12 (PVIN), U3.13 (EN)
GND: C1.2, C2.2, C3.2, C4.2, C5.2, C6.2, C7.2, C8.2, C9.2, C10.2, C11.2, C12.2, C13.2, C14.2, C15.2, C16.2, J5.1, J6.1, Q2.2 (S), Q3.2 (S), R5.2, R7.2, R8.1, R9.1, R10.1, R11.1, R12.2, R14.1, R15.2, R20.2, U1.6 (SYNC), U1.7 (AGND), U1.11 (NC), U1.12 (PGND), U1.13 (PGND), U1.14 (PGND), U1.15 (EP/AGND), U2.6 (EN1), U2.8 (VSS), U2.14 (TMR), U2.17 (VSS), U3.6 (AGND), U3.8 (DEF), U3.15 (PGND), U3.16 (PGND), U3.17 (EP); also elsewhere on the board
unnamed: C1.1, U1.5 (SS)
unnamed: C3.1, R6.1
unnamed: C5.1, R6.2, U1.8 (COMP)
unnamed: C12.1, U3.9 (SS/TR)
unnamed: D2.2 (A), Q1.1 (G), R7.1
unnamed: D3.2 (A), L1.2, U1.1 (SW), U1.2 (SW)
unnamed: F1.1, Q1.3 (D)
unnamed: F1.2, J6.2
unnamed: J5.2, U2.13 (IN)
unnamed: L2.1, U3.1 (SW), U3.2 (SW), U3.3 (SW)
unnamed: Q2.1 (G), Q3.1 (G), R16.2
unnamed: Q2.3 (D), Q4.1 (G), R17.2
unnamed: Q3.3 (D), Q5.1 (G), R18.2
unnamed: R5.1, U1.10 (FREQ)
unnamed: R8.2, U2.15 (ITERM)
unnamed: R9.2, U2.4 (~CE)
unnamed: R10.2, U2.12 (ILIM)
unnamed: R11.2, U2.16 (ISET)
unnamed: R12.1, U2.1 (TS)
unnamed: R13.2, R14.2, U1.9 (FB)
unnamed: R19.2, R20.1, U3.5 (FB)

Notes on the sheet:
VIN: 3.3-15 V VOUT: 3.3 V IOUT: 3 A FREQ: 1.25 MHz Designed according to WEBENCH
BATTERY IN
5V Supply
4.4V-10V
Solar charging, undervoltage lockout and power path management
3.3-4.2 V (1S9P)
3.3V Supply
Reverse polarity protection & battery conenction
SOLAR IN
ISET set to 890/1500 = 593 mA ITERM set to 5600 * 0.03 / 1500 = 112 mA ILIM set to 1550 / 560 = 2.77 A
VIN: 3-4.5 V VOUT: 5 V IOUT: 1 A FREQ: 778.91 kHz Designed according to WEBENCH
TI recommends connecting NC to AGND
Switched rails

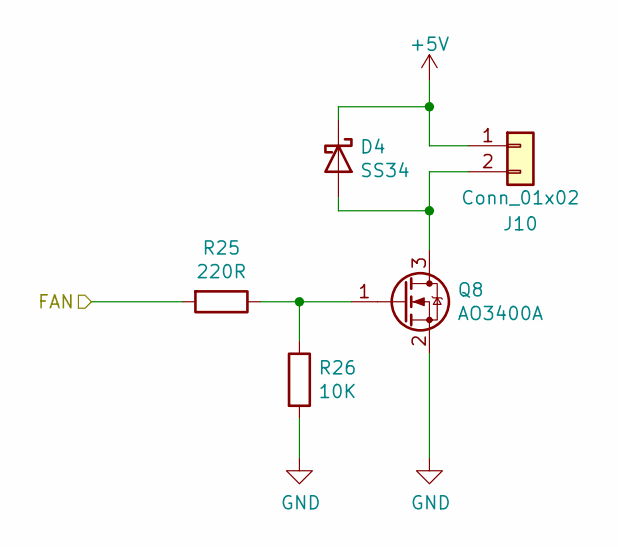
[picture p44: schematic Fan.kicad_sch, CO2 Chamber - Fan Driver]

Parts:
D4: SS34; D_SMA; LCSC C8678
J10: Conn_01x02; JST_XH_B2B-XH-AM_1x02_P2.50mm_Vertical; LCSC C20079
Q8: AO3400A; SOT-23; LCSC C20917
R25: 220R; R_0603_1608Metric
R26: 10K; R_0603_1608Metric

Connections:
+5V: D4.1 (K), J10.1; also elsewhere on the board
/Fan/FAN: R25.2; also elsewhere on the board
GND: Q8.2 (S), R26.2; also elsewhere on the board
unnamed: D4.2 (A), J10.2, Q8.3 (D)
unnamed: Q8.1 (G), R25.1, R26.1

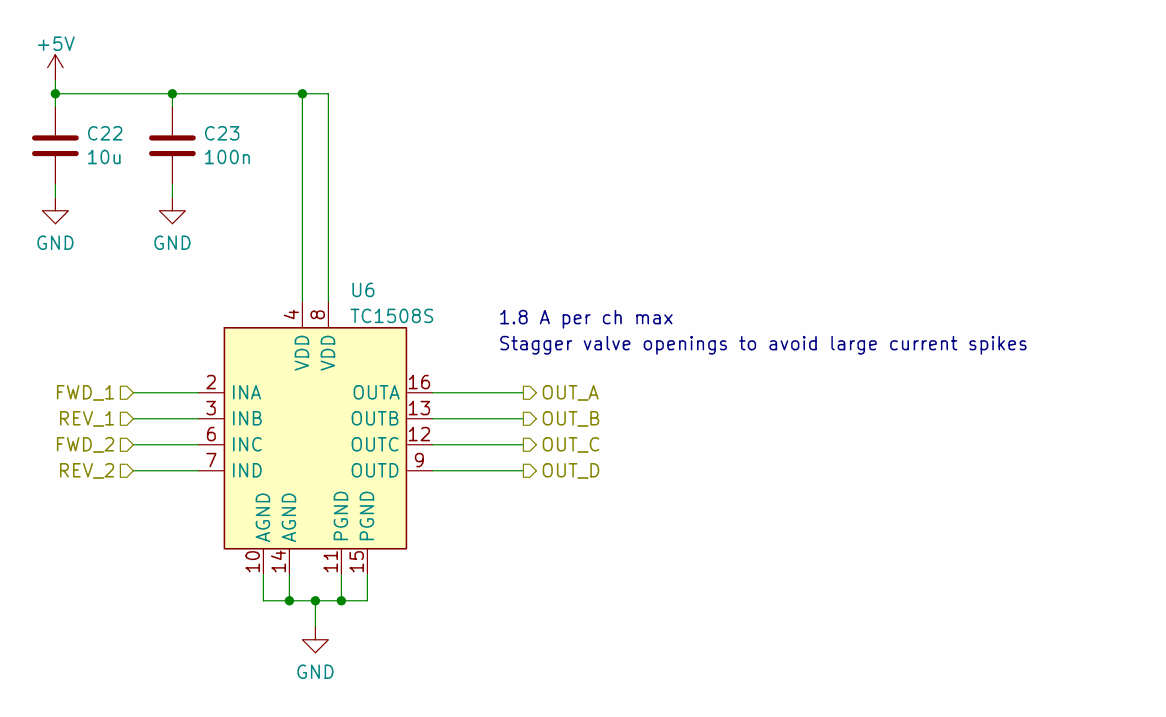
[picture p45: schematic Valve_Driver.kicad_sch, CO2 Chamber - Valve Driver]

Parts:
C22: 10u; C_0805_2012Metric; LCSC C15850
C23: 100n; C_0603_1608Metric; LCSC C14663
U6: TC1508S; SOP-16_3.9x9.9mm_P1.27mm; LCSC C89480

Connections:
+5V: C22.1, C23.1, U6.4 (VDD), U6.8 (VDD); also elsewhere on the board
/Microprocessor section/VALVE_1_FWD: U6.2 (INA); also elsewhere on the board
/Microprocessor section/VALVE_1_REV: U6.3 (INB); also elsewhere on the board
/Microprocessor section/VALVE_2_FWD: U6.6 (INC); also elsewhere on the board
/Microprocessor section/VALVE_2_REV: U6.7 (IND); also elsewhere on the board
/Valve Driver/OUT_A: U6.16 (OUTA); also elsewhere on the board
/Valve Driver/OUT_B: U6.13 (OUTB); also elsewhere on the board
/Valve Driver/OUT_C: U6.12 (OUTC); also elsewhere on the board
/Valve Driver/OUT_D: U6.9 (OUTD); also elsewhere on the board
GND: C22.2, C23.2, U6.10 (AGND), U6.11 (PGND), U6.14 (AGND), U6.15 (PGND); also elsewhere on the board

Notes on the sheet:
1.8 A per ch max
Stagger valve openings to avoid large current spikes

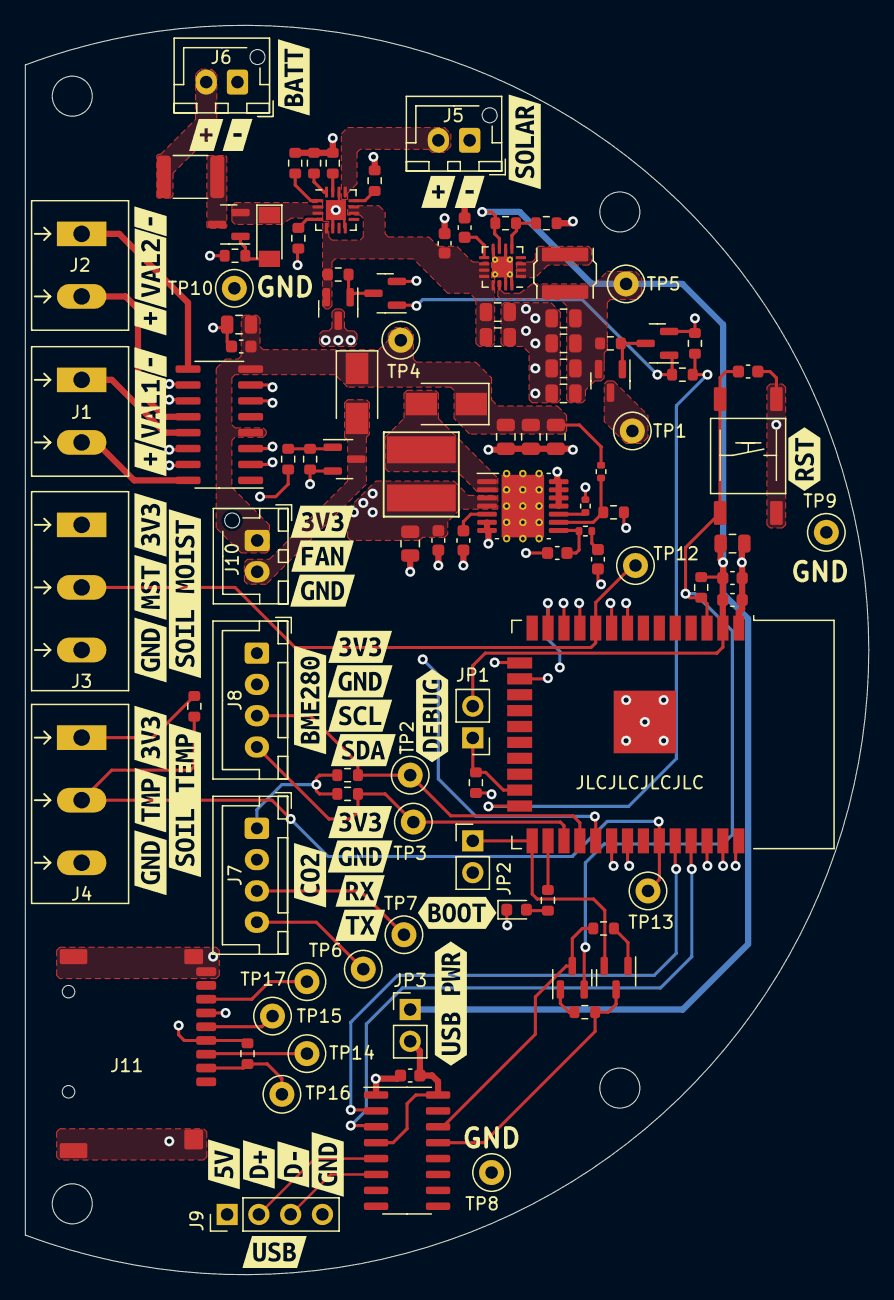
[picture p46: board co2_sensor_node.kicad_pcb from above]

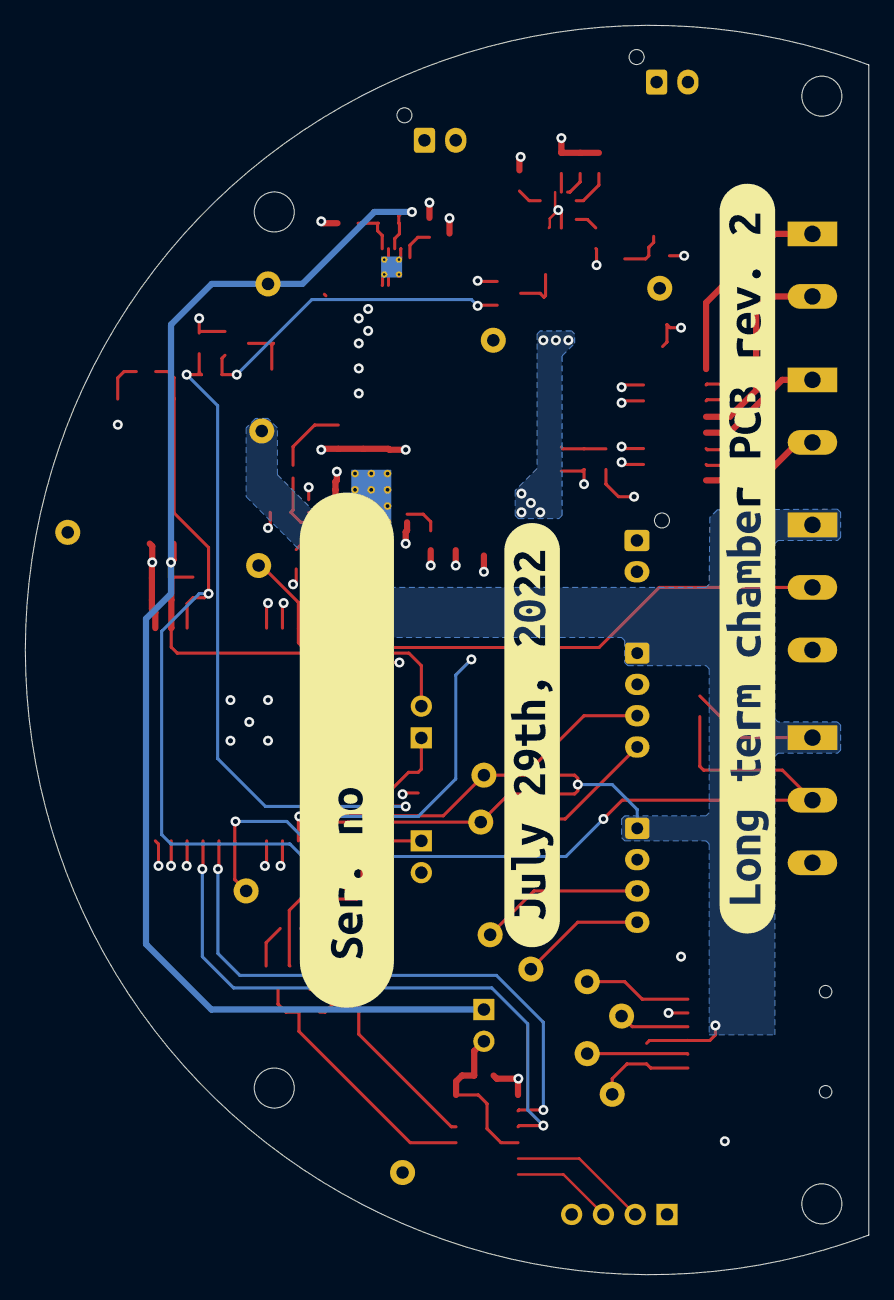
[picture p47: board co2_sensor_node.kicad_pcb from below]

Board: 4 copper layers, 67.4 x 99.8 mm, 151 parts (3 on the bottom side), 64 nets.

Other parts of the board:
kibuzzard-62D933FC: G***; kibuzzard-62D933FC
kibuzzard-62D936A1: G***; kibuzzard-62D936A1
kibuzzard-62D936BA: G***; kibuzzard-62D936BA
kibuzzard-62D936C1: G***; kibuzzard-62D936C1
kibuzzard-62D936C8: G***; kibuzzard-62D936C8
kibuzzard-62D936D1: G***; kibuzzard-62D936D1
kibuzzard-62D95196: G***; kibuzzard-62D95196
kibuzzard-62E4018B: G***; kibuzzard-62E4018B
kibuzzard-62E4020F: G***; kibuzzard-62E4020F
kibuzzard-62E91481: G***; kibuzzard-62E91481
kibuzzard-628CFF9F: G***; kibuzzard-628CFF9F
kibuzzard-628CFF95: G***; kibuzzard-628CFF95
kibuzzard-628CFFA6: G***; kibuzzard-628CFFA6
kibuzzard-628CFFAE: G***; kibuzzard-628CFFAE
kibuzzard-628CFFC0: G***; kibuzzard-628CFFC0
kibuzzard-628CFFCE: G***; kibuzzard-628CFFCE
kibuzzard-628D01AC: G***; kibuzzard-628D01AC
kibuzzard-628D01D9: G***; kibuzzard-628D01D9
kibuzzard-628D06EC: G***; kibuzzard-628D06EC
kibuzzard-628D076D, kibuzzard-628D076D#2, kibuzzard-628D076D#3, kibuzzard-628D076D#4: G***; kibuzzard-628D076D
kibuzzard-628D082D: G***; kibuzzard-628D082D
kibuzzard-628D085C: G***; kibuzzard-628D085C
kibuzzard-628D086F: G***; kibuzzard-628D086F
kibuzzard-628D087A: G***; kibuzzard-628D087A
kibuzzard-628D090E: G***; kibuzzard-628D090E
kibuzzard-628D091C: G***; kibuzzard-628D091C
kibuzzard-628D0108: G***; kibuzzard-628D0108
kibuzzard-628D0120: G***; kibuzzard-628D0120
kibuzzard-628D0190: G***; kibuzzard-628D0190
kibuzzard-628D0781, kibuzzard-628D0781#2, kibuzzard-628D0781#3, kibuzzard-628D0781#4: G***; kibuzzard-628D0781
kibuzzard-628D0804: G***; kibuzzard-628D0804
kibuzzard-628D0814: G***; kibuzzard-628D0814
kibuzzard-628D0827: G***; kibuzzard-628D0827
kibuzzard-628D0915: G***; kibuzzard-628D0915
kibuzzard-628D0922: G***; kibuzzard-628D0922
kibuzzard-628D0934: G***; kibuzzard-628D0934
kibuzzard-628E3C8D: G***; kibuzzard-628E3C8D
kibuzzard-628E3C65: G***; kibuzzard-628E3C65
kibuzzard-629F65FE: G***; kibuzzard-629F65FE
