cemis-iceland/co2_sensor_node/(commit log)

2021-05-19 Change mcp reset pin cap to 100n, add uart2 lines
    [Microprocessor_section.sch]
2021-05-19 Design CO2 sensor connector
    Connectors for the SCD30 and the K30FR.
    Including high side load switch.
    [CO2_Sensor_Connector.sch, LoRa_Transceiver.sch, SD_card.sch]
2021-05-19 Fix atmo sensor, add LoRa schematic
    [Atmo_sensor.sch, CO2_Sensor_Connector.sch, LoRa_Transceiver.sch, SD_card.sch]
2021-05-19 Rearranged IO connections to take advantage of hardware interfaces where possible
    [CO2_Sensor_Connector.sch, Microprocessor_section.sch, SD_card.sch]
2021-05-21 Connect SD card
    [SD_card.sch]
2021-05-21 Draw power schematic
    [Power.sch]
2021-05-21 Change BME280 out for connector
    [Atmo_sensor.sch, CO2_Sensor_Connector.sch, GNSS.sch, LoRa_Transceiver.sch, Microprocessor_section.sch, Power.sch, SD_card.sch, co2_sensor_node.sch]
2021-05-21 Begin assigning footprints
    [Atmo_sensor.sch, CO2_Sensor_Connector.sch, GNSS.sch, LoRa_Transceiver.sch, Microprocessor_section.sch, Power.sch, SD_card.sch]
2021-05-25 Finish attaching footprints for revision 1
    [CO2_Sensor_Connector.sch, LoRa_Transceiver.sch, Microprocessor_section.sch, Power.sch, SD_card.sch]
2021-05-25 Actually include footprint library
2021-05-25 Start changing buck converters
    [CO2_Sensor_Connector.sch, Power.sch]
2021-05-25 Finished revising power section schematic
    [Power.sch]
2021-05-26 Start PCB layout
    [CO2_Sensor_Connector.sch, Microprocessor_section.sch, Power.sch, co2_sensor_node.kicad_pcb, co2_sensor_node.sch]
2021-05-26 First cut at layout
    [CO2_Sensor_Connector.sch, LoRa_Transceiver.sch, Microprocessor_section.sch, Power.sch, SD_card.sch, co2_sensor_node.kicad_pcb]
2021-05-27 Start routing power section
    [co2_sensor_node.kicad_pcb]
2021-05-27 Layout complete, barring review and polish
    [CO2_Sensor_Connector.sch, Microprocessor_section.sch, co2_sensor_node.kicad_pcb]
2021-05-28 Export fabrication files
    [CO2_Sensor_Connector.sch, LoRa_Transceiver.sch, Microprocessor_section.sch, Power.sch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]
2021-05-28 Remove csv from gitignore
    [BOM.csv, PnP.csv]
2021-06-03 Start changing design for long term chambers
    [Microprocessor_section.sch, Power.sch, Pump_Driver.sch, SD_card.sch, co2_sensor_node.sch]
2021-06-21 Fix sensor PMOS issue and start change to long term chamber
    [CO2_Sensor_Connector.sch, Power.sch]
2021-06-21 Add MPPT battery charger and polyfuse, replace reverse polarity
    [CO2_Sensor_Connector.sch, Microprocessor_section.sch, Power.sch, Pump_Driver.sch]
2021-06-21 Remove all references to 6V supply which has been removed
    [CO2_Sensor_Connector.sch, Pump_Driver.sch]
2021-06-21 Add connector for external chamber connection and change SMA to U.FL connector
    [LoRa_Transceiver.sch, co2_sensor_node.sch]
2021-06-22 Finalize schematic
    [Atmo_sensor.sch, CO2_Sensor_Connector.sch, Microprocessor_section.sch, Power.sch, Pump_Driver.sch, co2_sensor_node.sch]
2021-07-01 Finish routing of Rev 1
    [Atmo_sensor.sch, CO2_Sensor_Connector.sch, Fan.sch, LoRa_Transceiver.sch, Microprocessor_section.sch, Power.sch, Pump_Driver.sch, SD_card.sch]
2022-05-13 Remove unused circuits
    [Atmo_sensor.kicad_sch, CO2_Sensor_Connector.kicad_sch, Fan.kicad_sch, LoRa_Transceiver.kicad_sch, Microprocessor_section.kicad_sch, Power.kicad_sch, Pump_Driver.kicad_sch, SD_card.kicad_sch]
2022-05-19 Move to KiCad v6, redesign circuit for chamber
    [Atmo_sensor.kicad_sch, CO2_Sensor_Connector.kicad_sch, Fan.kicad_sch, Microprocessor_section.kicad_sch, Power.kicad_sch, Pump_Driver.kicad_sch, SD_card.kicad_sch, SOP-8_4.4x5.0mm_P1.27mm.step]
2022-05-19 Add test points, add JLC part numbers to JST XH connectors, clean up
    [Fan.kicad_sch, Microprocessor_section.kicad_sch, Power.kicad_sch, Pump_Driver.kicad_sch, SD_card.kicad_sch, Valve_Driver.kicad_sch, co2_sensor_node.kicad_sch]
2022-05-20 Add testpoint footprint assignments
    [Power.kicad_sch, SD_card.kicad_sch, Status_LED.kicad_sch, Valve_Driver.kicad_sch, co2_sensor_node.kicad_sch]
2022-05-25 Finish PCB layout
    [Atmo_sensor.kicad_sch, CO2_Sensor_Connector.kicad_sch, Microprocessor_section.kicad_sch, co2_sensor_node.kicad_pcb, co2_sensor_node.kicad_sch, co2_sensor_node.step]
2022-05-25 fixed the HOLE by adding rounded corners
    [co2_sensor_node.kicad_pcb]
2022-05-25 New step model
    [co2_sensor_node.kicad_pcb, co2_sensor_node.step]
2022-05-30 Add voltage selection header for fan
    [Fan.kicad_sch, SD_card.kicad_sch, Valve_Driver.kicad_sch, co2_sensor_node.kicad_pcb, co2_sensor_node.kicad_sch]
2022-05-30 Clean folder up a bit
    [Atmo_sensor.sch, Atmo_sensor_connector.sch, CO2_Sensor_Connector.sch, Fan.sch, GNSS.sch, LoRa_Transceiver.kicad_sch, LoRa_Transceiver.sch, Microprocessor_section.sch]
2022-06-07 Finalize PCB and generate manufacturing files
    [BOM.csv, PnP.csv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]
2022-07-11 Start redesign for rev. 2
    [Atmo_sensor.kicad_sch, CO2_Sensor_Connector.kicad_sch, Fan.kicad_sch, Microprocessor_section.kicad_sch, Power.kicad_sch, SD_card.kicad_sch, Valve_Driver.kicad_sch, co2_sensor_node.kicad_sch]
2022-07-19 Finish rev. 2 schematic and begin PCB layout
    [Atmo_sensor.kicad_sch, CO2_Sensor_Connector.kicad_sch, Fan.kicad_sch, Microprocessor_section.kicad_sch, Power.kicad_sch, SD_card.kicad_sch, Valve_Driver.kicad_sch, co2_sensor_node.kicad_pcb]
2022-07-20 Continued PCB layout
    [co2_sensor_node.kicad_pcb]
2022-07-26 Add 5V boost converter and begin redesign of PCB
    [Atmo_sensor.kicad_sch, CO2_Sensor_Connector.kicad_sch, Fan.kicad_sch, Microprocessor_section.kicad_sch, Power.kicad_sch, SD_card.kicad_sch, Valve_Driver.kicad_sch, co2_sensor_node.kicad_pcb]
2022-07-27 More layout work
    [Valve_Driver.kicad_sch, co2_sensor_node.kicad_pcb, co2_sensor_node.kicad_sch]
2022-07-28 Finish component placement
    [Atmo_sensor.kicad_sch, CO2_Sensor_Connector.kicad_sch, Fan.kicad_sch, Valve_Driver.kicad_sch, co2_sensor_node.kicad_pcb, co2_sensor_node.kicad_sch]
2022-07-29 I was never here
    [Atmo_sensor.kicad_sch, CO2_Sensor_Connector.kicad_sch, Fan.kicad_sch, Microprocessor_section.kicad_sch, Power.kicad_sch, SD_card.kicad_sch, Valve_Driver.kicad_sch, co2_sensor_node.kicad_sch]
2022-07-29 Finish routing PCB revision 2
    [Microprocessor_section.kicad_sch, co2_sensor_node.kicad_pcb, co2_sensor_node.kicad_sch]
2022-08-04 Finish routing round 2
    [Atmo_sensor.kicad_sch, CO2_Sensor_Connector.kicad_sch, Fan.kicad_sch, Microprocessor_section.kicad_sch, Power.kicad_sch, SD_card.kicad_sch, Valve_Driver.kicad_sch, co2_sensor_node.kicad_pcb]
